osprey-dcs/trigger-output-fmc/trigger-output-fmc.kicad_pcb

## KiCad design trigger-output-fmc.kicad_pcb (2026-10-09)

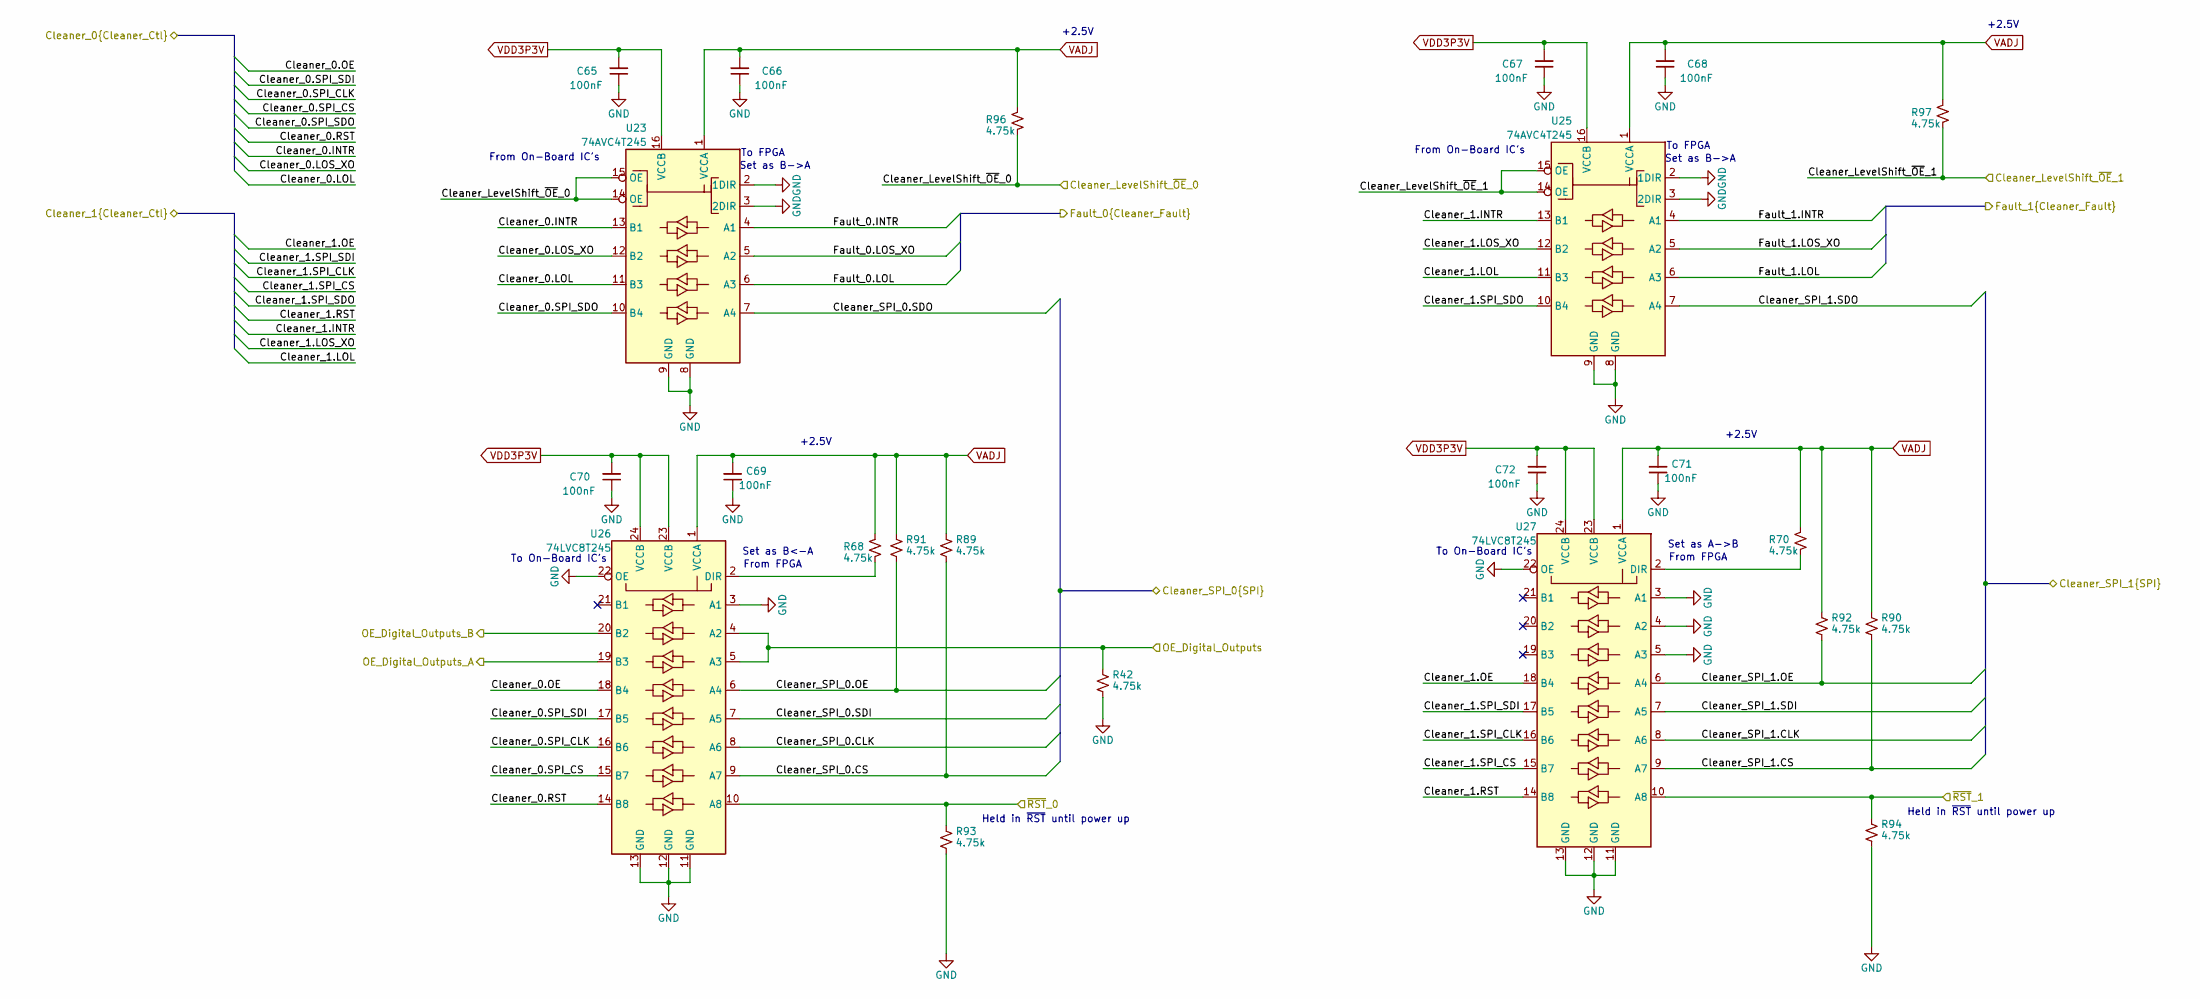
[picture p1: schematic Level_Shift.kicad_sch, Trigger Output FMC]

Parts:
C65, C66, C67, C68, C69, C70, C71, C72: 100nF; C_0402_1005Metric; MPN GCM155R71H104KE02J
R42, R68, R70, R89, R90, R91, R92, R93, R94, R96, R97: 4.75k; R_0402_1005Metric; MPN RC0402FR-074K75L
U23, U25: 74AVC4T245; TSSOP-16_4.4x5mm_P0.65mm; MPN SN74AVC4T245PWR
U26, U27: 74LVC8T245; TSSOP-24_4.4x7.8mm_P0.65mm; MPN SN74LVC8T245PWR

Connections:
/Digital IO/OE_A: U26.19 (B3); also elsewhere on the board
/Digital IO/OE_B: U26.20 (B2); also elsewhere on the board
/FMC/Cleaner_Fault_0.INTR: U23.4 (A1); also elsewhere on the board
/FMC/Cleaner_Fault_0.LOL: U23.6 (A3); also elsewhere on the board
/FMC/Cleaner_Fault_0.LOS_XO: U23.5 (A2); also elsewhere on the board
/FMC/Cleaner_Fault_1.INTR: U25.4 (A1); also elsewhere on the board
/FMC/Cleaner_Fault_1.LOL: U25.6 (A3); also elsewhere on the board
/FMC/Cleaner_Fault_1.LOS_XO: U25.5 (A2); also elsewhere on the board
/FMC/Cleaner_LevelShift_~OE_0: R96.1, U23.14 (OE), U23.15 (OE); also elsewhere on the board
/FMC/Cleaner_LevelShift_~OE_1: R97.1, U25.14 (OE), U25.15 (OE); also elsewhere on the board
/FMC/Cleaner_SPI_0.CLK: U26.8 (A6); also elsewhere on the board
/FMC/Cleaner_SPI_0.CS: R89.1, U26.9 (A7); also elsewhere on the board
/FMC/Cleaner_SPI_0.OE: R91.1, U26.6 (A4); also elsewhere on the board
/FMC/Cleaner_SPI_0.SDI: U26.7 (A5); also elsewhere on the board
/FMC/Cleaner_SPI_0.SDO: U23.7 (A4); also elsewhere on the board
/FMC/Cleaner_SPI_1.CLK: U27.8 (A6); also elsewhere on the board
/FMC/Cleaner_SPI_1.CS: R90.1, U27.9 (A7); also elsewhere on the board
/FMC/Cleaner_SPI_1.OE: R92.1, U27.6 (A4); also elsewhere on the board
/FMC/Cleaner_SPI_1.SDI: U27.7 (A5); also elsewhere on the board
/FMC/Cleaner_SPI_1.SDO: U25.7 (A4); also elsewhere on the board
/FMC/Cleaner_~RST_0: R93.2, U26.10 (A8); also elsewhere on the board
/FMC/Cleaner_~RST_1: R94.2, U27.10 (A8); also elsewhere on the board
/FMC/OE_Digital_Outputs: R42.2, U26.4 (A2), U26.5 (A3); also elsewhere on the board
/Jitter Cleaner0/Control.INTR: U23.13 (B1); also elsewhere on the board
/Jitter Cleaner0/Control.LOL: U23.11 (B3); also elsewhere on the board
/Jitter Cleaner0/Control.LOS_XO: U23.12 (B2); also elsewhere on the board
/Jitter Cleaner0/Control.OE: U26.18 (B4); also elsewhere on the board
/Jitter Cleaner0/Control.RST: U26.14 (B8); also elsewhere on the board
/Jitter Cleaner0/Control.SPI_CLK: U26.16 (B6); also elsewhere on the board
/Jitter Cleaner0/Control.SPI_CS: U26.15 (B7); also elsewhere on the board
/Jitter Cleaner0/Control.SPI_SDI: U26.17 (B5); also elsewhere on the board
/Jitter Cleaner0/Control.SPI_SDO: U23.10 (B4); also elsewhere on the board
/Jitter Cleaner1/Control.INTR: U25.13 (B1); also elsewhere on the board
/Jitter Cleaner1/Control.LOL: U25.11 (B3); also elsewhere on the board
/Jitter Cleaner1/Control.LOS_XO: U25.12 (B2); also elsewhere on the board
/Jitter Cleaner1/Control.OE: U27.18 (B4); also elsewhere on the board
/Jitter Cleaner1/Control.RST: U27.14 (B8); also elsewhere on the board
/Jitter Cleaner1/Control.SPI_CLK: U27.16 (B6); also elsewhere on the board
/Jitter Cleaner1/Control.SPI_CS: U27.15 (B7); also elsewhere on the board
/Jitter Cleaner1/Control.SPI_SDI: U27.17 (B5); also elsewhere on the board
/Jitter Cleaner1/Control.SPI_SDO: U25.10 (B4); also elsewhere on the board
GND: C65.1, C66.1, C67.1, C68.1, C69.1, C70.1, C71.1, C72.1, R42.1, R93.1, R94.1, U23.2 (1DIR), U23.3 (2DIR), U23.8 (GND), U23.9 (GND), U25.2 (1DIR), U25.3 (2DIR), U25.8 (GND), U25.9 (GND), U26.3 (A1), U26.11 (GND), U26.12 (GND), U26.13 (GND), U26.22 (OE), U27.3 (A1), U27.4 (A2), U27.5 (A3), U27.11 (GND), U27.12 (GND), U27.13 (GND), U27.22 (OE); also elsewhere on the board
unnamed: R68.1, U26.2 (DIR)
unnamed: R70.1, U27.2 (DIR)
VADJ: C66.2, C68.2, C69.2, C71.2, R68.2, R70.2, R89.2, R90.2, R91.2, R92.2, R96.2, R97.2, U23.1 (VCCA), U25.1 (VCCA), U26.1 (VCCA), U27.1 (VCCA); also elsewhere on the board
VDD3P3V: C65.2, C67.2, C70.2, C72.2, U23.16 (VCCB), U25.16 (VCCB), U26.23 (VCCB), U26.24 (VCCB), U27.23 (VCCB), U27.24 (VCCB); also elsewhere on the board

Notes on the sheet:
Held in ~{RST} until power up
To FPGA
To On-Board IC's
+2.5V
From On-Board IC's
Set as B<-A
From FPGA
Set as B->A
Set as A->B

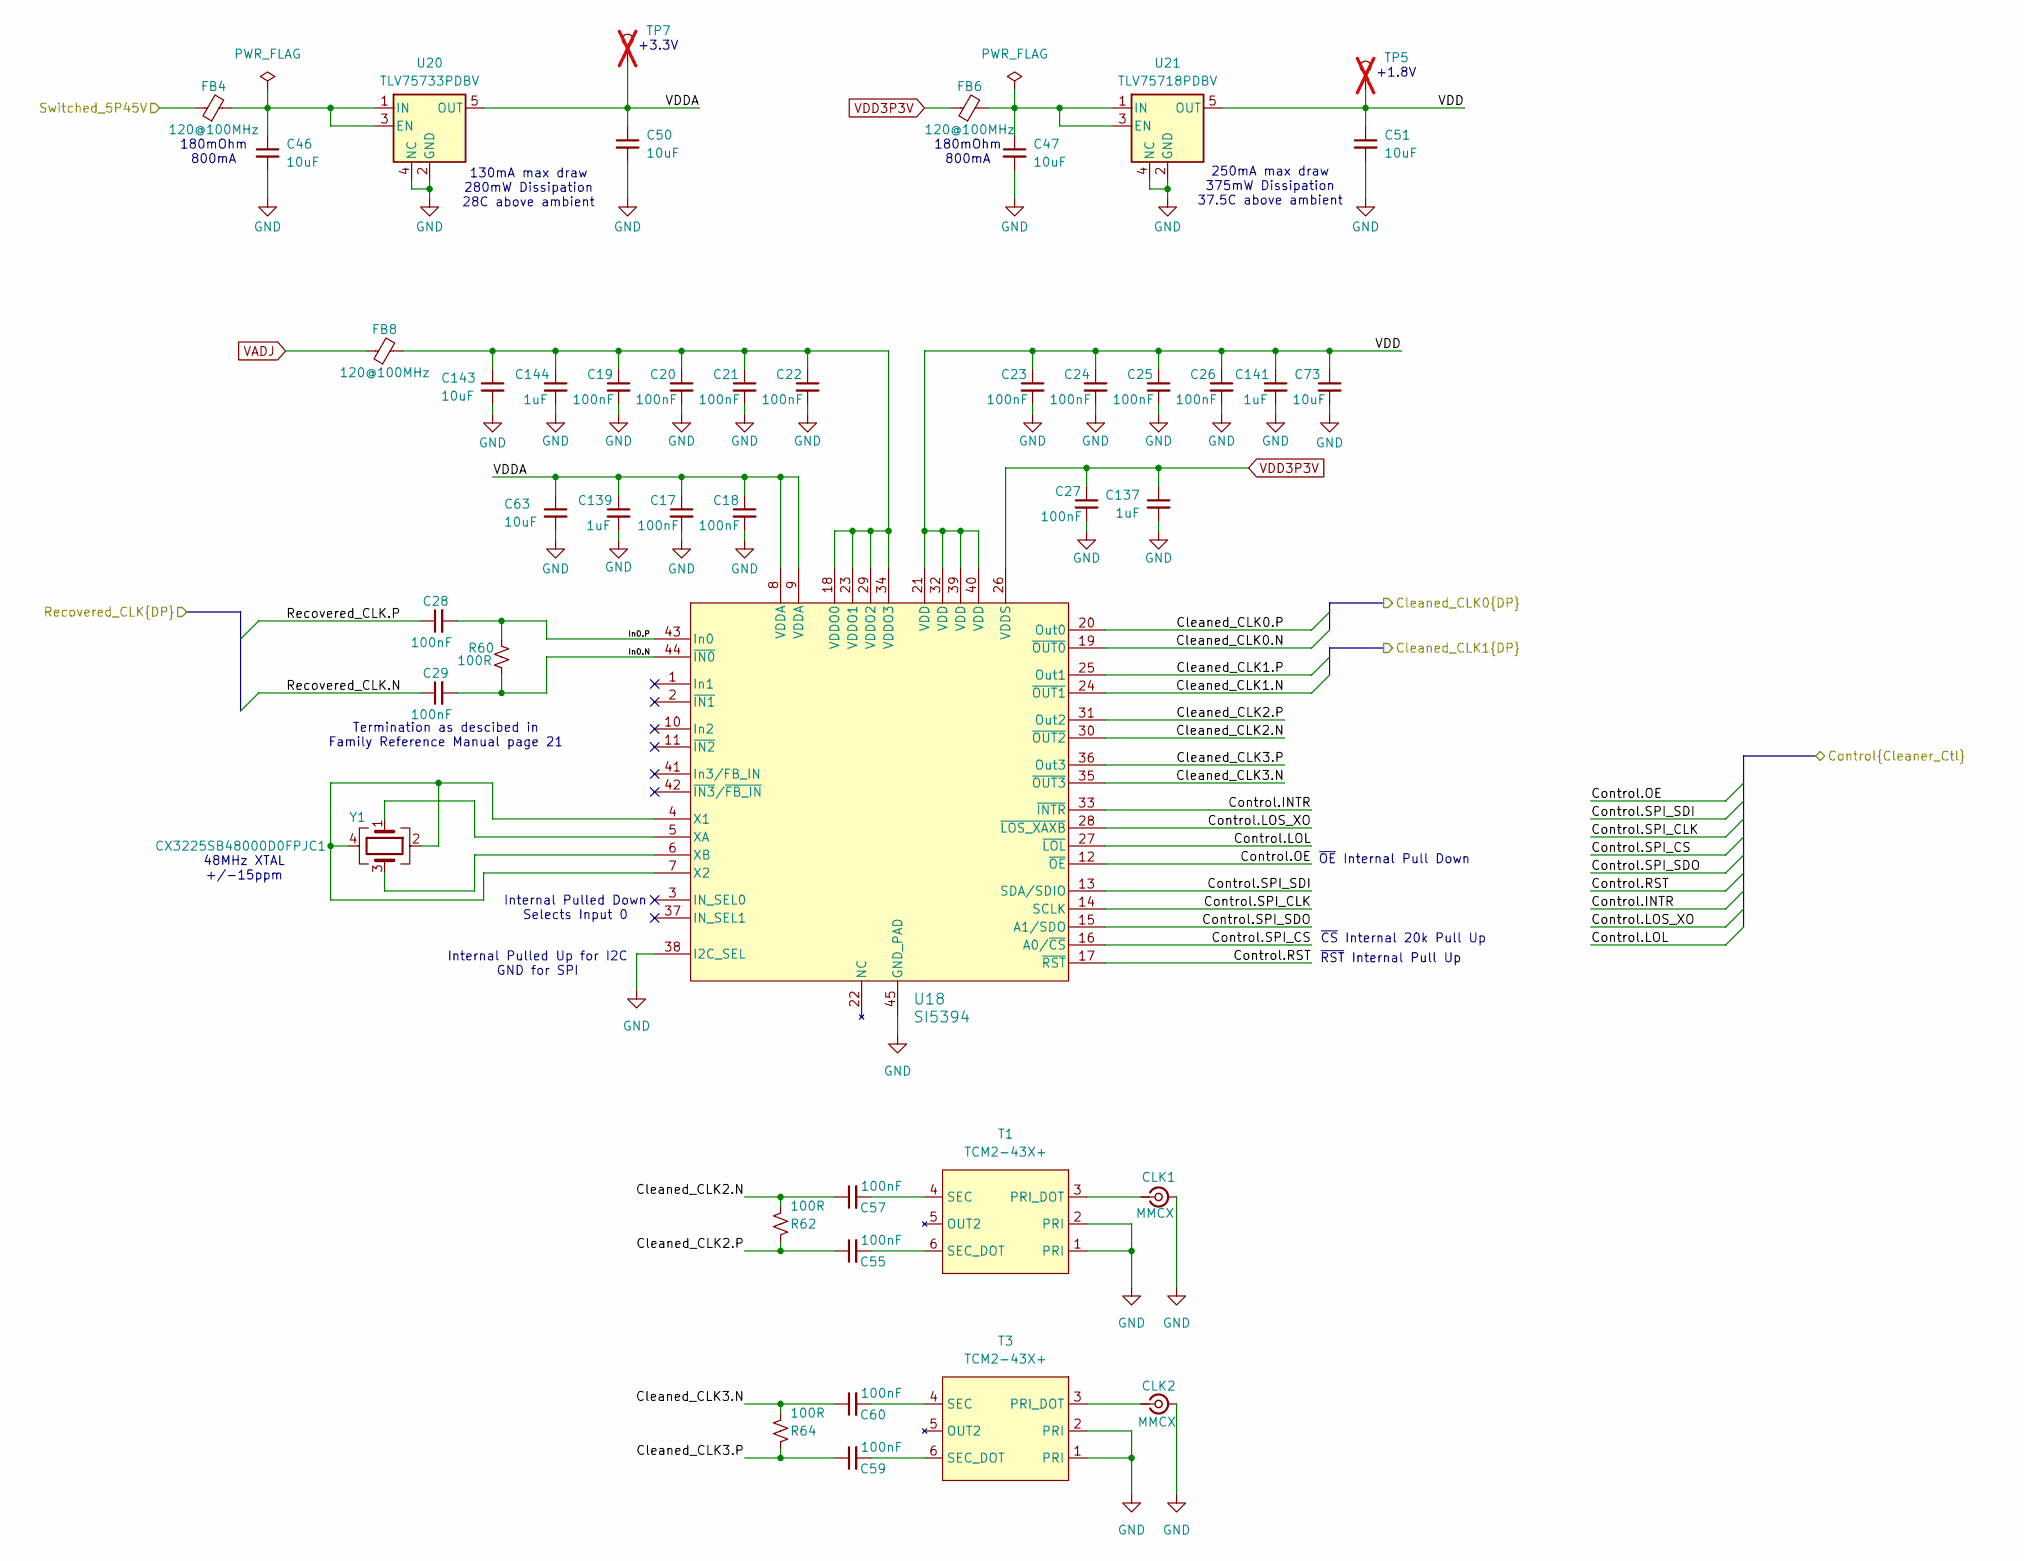
[picture p2: schematic Jitter_Cleaner.kicad_sch, Trigger Output FMC]

Parts:
C17, C18, C19, C20, C21, C22, C23, C24, C25, C26, C27, C28, C29, C55, C57, C59, C60: 100nF; C_0402_1005Metric; MPN GCM155R71H104KE02J
C46, C47, C50, C51, C63, C73, C143: 10uF; C_0805_2012Metric; MPN GRM21BR61E106KA73L
C137, C139, C141, C144: 1uF; C_0603_1608Metric; MPN GCM188R71E105KA64D
CLK1, CLK2: MMCX; MMCX_Molex_73415-1471_Vertical; MPN MMCX-J-P-H-ST-TH1
FB4, FB6, FB8: 120@100MHz; L_0603_1608Metric; MPN BLM18AG121SN1D
R60: 100R; R_0402_1005Metric; MPN RC0402FR-07100RL
R62, R64: 100R; R_0603_1608Metric; MPN RG1608P-101-B-T5
T1, T3: TCM2-43X+; Mini-Circuits_DB1627_rounded_pads; MPN TCM2-43X+
TP5, TP7: Keystone5000; TestPoint_Keystone_5000-5004_Miniature; MPN 5000; not fitted
U18: SI5394; QFN-44-1EP_7x7mm_P0.5mm_EP5.2x5.2mm_ThermalVias; MPN SI5394A-A-GM
U20: TLV75733PDBV; SOT-23-5; MPN TLV75733PDBV
U21: TLV75718PDBV; SOT-23-5; MPN TLV75718PDBV
Y1: CX3225SB48000D0FPJC1; Crystal_SMD_Abracon_ABM8AIG-4Pin_3.2x2.5mm; MPN CX3225SB48000D0FPJC1

Connections:
/Digital IO/Switched_5P45V: FB4.1; also elsewhere on the board
/FMC/Cleaned_CLK_0.N: U18.19 (~OUT0); also elsewhere on the board
/FMC/Cleaned_CLK_0.P: U18.20 (Out0); also elsewhere on the board
/FMC/FMC_GBTCLK0.N: U18.24 (~OUT1); also elsewhere on the board
/FMC/FMC_GBTCLK0.P: U18.25 (Out1); also elsewhere on the board
/FMC/Recovered_CLK_0.N: C29.1; also elsewhere on the board
/FMC/Recovered_CLK_0.P: C28.1; also elsewhere on the board
/Jitter Cleaner0/Cleaned_CLK2.N: C57.1, R62.2, U18.30 (~OUT2)
/Jitter Cleaner0/Cleaned_CLK2.P: C55.1, R62.1, U18.31 (Out2)
/Jitter Cleaner0/Cleaned_CLK3.N: C60.1, R64.2, U18.35 (~OUT3)
/Jitter Cleaner0/Cleaned_CLK3.P: C59.1, R64.1, U18.36 (Out3)
/Jitter Cleaner0/Control.INTR: U18.33 (~INTR); also elsewhere on the board
/Jitter Cleaner0/Control.LOL: U18.27 (~LOL); also elsewhere on the board
/Jitter Cleaner0/Control.LOS_XO: U18.28 (~LOS_XAXB); also elsewhere on the board
/Jitter Cleaner0/Control.OE: U18.12 (~OE); also elsewhere on the board
/Jitter Cleaner0/Control.RST: U18.17 (~RST); also elsewhere on the board
/Jitter Cleaner0/Control.SPI_CLK: U18.14 (SCLK); also elsewhere on the board
/Jitter Cleaner0/Control.SPI_CS: U18.16 (A0/~CS); also elsewhere on the board
/Jitter Cleaner0/Control.SPI_SDI: U18.13 (SDA/SDIO); also elsewhere on the board
/Jitter Cleaner0/Control.SPI_SDO: U18.15 (A1/SDO); also elsewhere on the board
/Jitter Cleaner0/In0.N: C29.2, R60.2, U18.44 (~IN0)
/Jitter Cleaner0/In0.P: C28.2, R60.1, U18.43 (In0)
/Jitter Cleaner0/VDD: C23.1, C24.1, C25.1, C26.1, C51.1, C73.1, C141.1, TP5.1, U18.21 (VDD), U18.32 (VDD), U18.39 (VDD), U18.40 (VDD), U21.5 (OUT)
/Jitter Cleaner0/VDDA: C17.1, C18.1, C50.1, C63.1, C139.1, TP7.1, U18.8 (VDDA), U18.9 (VDDA), U20.5 (OUT)
GND: C17.2, C18.2, C19.2, C20.2, C21.2, C22.2, C23.2, C24.2, C25.2, C26.2, C27.2, C46.2, C47.2, C50.2, C51.2, C63.2, C73.2, C137.2, C139.2, C141.2, C143.2, C144.2, CLK1.2 (Ext), CLK2.2 (Ext), T1.1 (PRI), T1.2 (PRI), T3.1 (PRI), T3.2 (PRI), U18.38 (I2C_SEL), U18.45 (GND_PAD), U20.2 (GND), U20.4 (NC), U21.2 (GND), U21.4 (NC); also elsewhere on the board
unnamed: CLK1.1 (In), T1.3 (PRI_DOT)
unnamed: CLK2.1 (In), T3.3 (PRI_DOT)
unnamed: C57.2, T1.4 (SEC)
unnamed: C55.2, T1.6 (SEC_DOT)
unnamed: C60.2, T3.4 (SEC)
unnamed: C59.2, T3.6 (SEC_DOT)
unnamed: C19.1, C20.1, C21.1, C22.1, C143.1, C144.1, FB8.2, U18.18 (VDDO0), U18.23 (VDDO1), U18.29 (VDDO2), U18.34 (VDDO3)
unnamed: U18.4 (X1), U18.7 (X2), Y1.2, Y1.4
unnamed: U18.5 (XA), Y1.1
unnamed: U18.6 (XB), Y1.3
unnamed: C46.1, FB4.2, U20.1 (IN), U20.3 (EN)
unnamed: C47.1, FB6.2, U21.1 (IN), U21.3 (EN)
VADJ: FB8.1; also elsewhere on the board
VDD3P3V: C27.1, C137.1, FB6.1, U18.26 (VDDS); also elsewhere on the board

Parts of its further copies:
C30, C31, C32, C36, C37, C38, C39, C40, C41, C42, C43, C44, C45, C56, C58, C61, C62: 100nF; C_0402_1005Metric; MPN GCM155R71H104KE02J
C64, C74, C75, C76, C77, C78, C145: 10uF; C_0805_2012Metric; MPN GRM21BR61E106KA73L
C138, C140, C142, C146: 1uF; C_0603_1608Metric; MPN GCM188R71E105KA64D
CLK3, CLK4: MMCX; MMCX_Molex_73415-1471_Vertical; MPN MMCX-J-P-H-ST-TH1
FB5, FB7, FB9: 120@100MHz; L_0603_1608Metric; MPN BLM18AG121SN1D
R61: 100R; R_0402_1005Metric; MPN RC0402FR-07100RL
R63, R65: 100R; R_0603_1608Metric; MPN RG1608P-101-B-T5
T2, T4: TCM2-43X+; Mini-Circuits_DB1627_rounded_pads; MPN TCM2-43X+
TP6, TP9: Keystone5000; TestPoint_Keystone_5000-5004_Miniature; MPN 5000; not fitted
U19: SI5394; QFN-44-1EP_7x7mm_P0.5mm_EP5.2x5.2mm_ThermalVias; MPN SI5394A-A-GM
U24: TLV75733PDBV; SOT-23-5; MPN TLV75733PDBV
U28: TLV75718PDBV; SOT-23-5; MPN TLV75718PDBV
Y2: CX3225SB48000D0FPJC1; Crystal_SMD_Abracon_ABM8AIG-4Pin_3.2x2.5mm; MPN CX3225SB48000D0FPJC1

Connections of its further copies:
/Digital IO/Switched_5P45V: FB5.1; also elsewhere on the board
/FMC/Cleaned_CLK_1.N: U19.24 (~OUT1); also elsewhere on the board
/FMC/Cleaned_CLK_1.P: U19.25 (Out1); also elsewhere on the board
/FMC/FMC_GBTCLK1.N: U19.19 (~OUT0); also elsewhere on the board
/FMC/FMC_GBTCLK1.P: U19.20 (Out0); also elsewhere on the board
/FMC/Recovered_CLK_1.N: C31.1; also elsewhere on the board
/FMC/Recovered_CLK_1.P: C30.1; also elsewhere on the board
/Jitter Cleaner1/Cleaned_CLK2.N: C58.1, R63.2, U19.30 (~OUT2)
/Jitter Cleaner1/Cleaned_CLK2.P: C56.1, R63.1, U19.31 (Out2)
/Jitter Cleaner1/Cleaned_CLK3.N: C62.1, R65.2, U19.35 (~OUT3)
/Jitter Cleaner1/Cleaned_CLK3.P: C61.1, R65.1, U19.36 (Out3)
/Jitter Cleaner1/Control.INTR: U19.33 (~INTR); also elsewhere on the board
/Jitter Cleaner1/Control.LOL: U19.27 (~LOL); also elsewhere on the board
/Jitter Cleaner1/Control.LOS_XO: U19.28 (~LOS_XAXB); also elsewhere on the board
/Jitter Cleaner1/Control.OE: U19.12 (~OE); also elsewhere on the board
/Jitter Cleaner1/Control.RST: U19.17 (~RST); also elsewhere on the board
/Jitter Cleaner1/Control.SPI_CLK: U19.14 (SCLK); also elsewhere on the board
/Jitter Cleaner1/Control.SPI_CS: U19.16 (A0/~CS); also elsewhere on the board
/Jitter Cleaner1/Control.SPI_SDI: U19.13 (SDA/SDIO); also elsewhere on the board
/Jitter Cleaner1/Control.SPI_SDO: U19.15 (A1/SDO); also elsewhere on the board
/Jitter Cleaner1/In0.N: C31.2, R61.2, U19.44 (~IN0)
/Jitter Cleaner1/In0.P: C30.2, R61.1, U19.43 (In0)
/Jitter Cleaner1/VDD: C41.1, C43.1, C44.1, C45.1, C74.1, C78.1, C142.1, TP9.1, U19.21 (VDD), U19.32 (VDD), U19.39 (VDD), U19.40 (VDD), U28.5 (OUT)
/Jitter Cleaner1/VDDA: C37.1, C39.1, C64.1, C76.1, C140.1, TP6.1, U19.8 (VDDA), U19.9 (VDDA), U24.5 (OUT)
GND: C32.2, C36.2, C37.2, C38.2, C39.2, C40.2, C41.2, C42.2, C43.2, C44.2, C45.2, C64.2, C74.2, C75.2, C76.2, C77.2, C78.2, C138.2, C140.2, C142.2, C145.2, C146.2, CLK3.2 (Ext), CLK4.2 (Ext), T2.1 (PRI), T2.2 (PRI), T4.1 (PRI), T4.2 (PRI), U19.38 (I2C_SEL), U19.45 (GND_PAD), U24.2 (GND), U24.4 (NC), U28.2 (GND), U28.4 (NC); also elsewhere on the board
unnamed: CLK3.1 (In), T2.3 (PRI_DOT)
unnamed: CLK4.1 (In), T4.3 (PRI_DOT)
unnamed: C58.2, T2.4 (SEC)
unnamed: C56.2, T2.6 (SEC_DOT)
unnamed: C62.2, T4.4 (SEC)
unnamed: C61.2, T4.6 (SEC_DOT)
unnamed: C32.1, C36.1, C38.1, C40.1, C145.1, C146.1, FB9.2, U19.18 (VDDO0), U19.23 (VDDO1), U19.29 (VDDO2), U19.34 (VDDO3)
unnamed: U19.4 (X1), U19.7 (X2), Y2.2, Y2.4
unnamed: U19.5 (XA), Y2.1
unnamed: U19.6 (XB), Y2.3
unnamed: C75.1, FB5.2, U24.1 (IN), U24.3 (EN)
unnamed: C77.1, FB7.2, U28.1 (IN), U28.3 (EN)
VADJ: FB9.1; also elsewhere on the board
VDD3P3V: C42.1, C138.1, FB7.1, U19.26 (VDDS); also elsewhere on the board

Notes on the sheet:
130mA max draw 280mW Dissipation 28C above ambient
~{CS} Internal 20k Pull Up
Internal Pulled Up for I2C GND for SPI
48MHz XTAL +/-15ppm
180mOhm 800mA
250mA max draw 375mW Dissipation 37.5C above ambient
~{RST} Internal Pull Up
Termination as descibed in Family Reference Manual page 21
+1.8V
+3.3V
Internal Pulled Down Selects Input 0
~{OE} Internal Pull Down

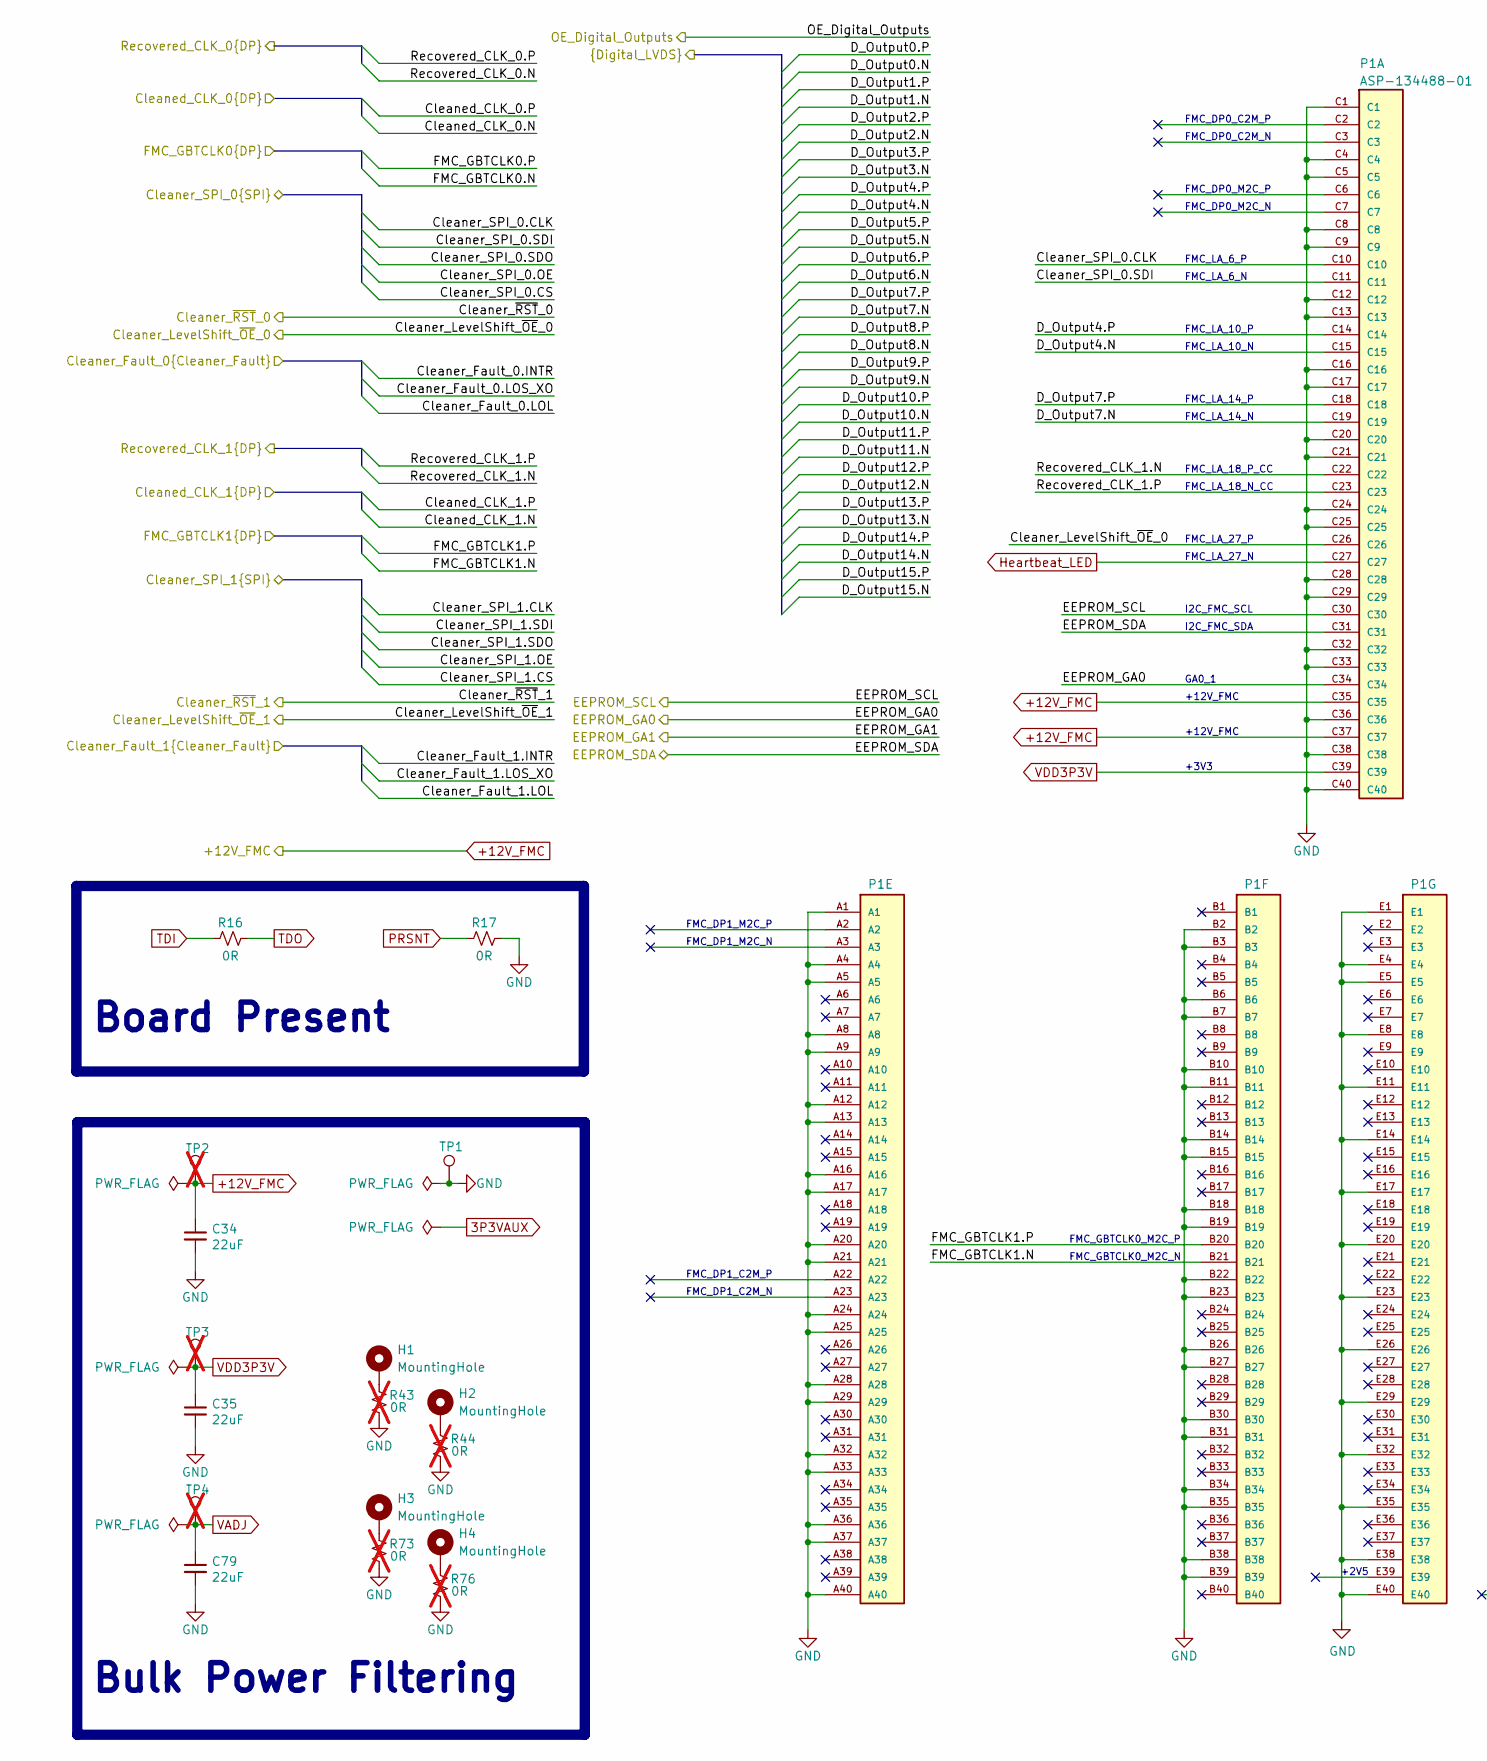
[picture p3: schematic fmc.kicad_sch, Trigger Output FMC, part in row 1, column 1]

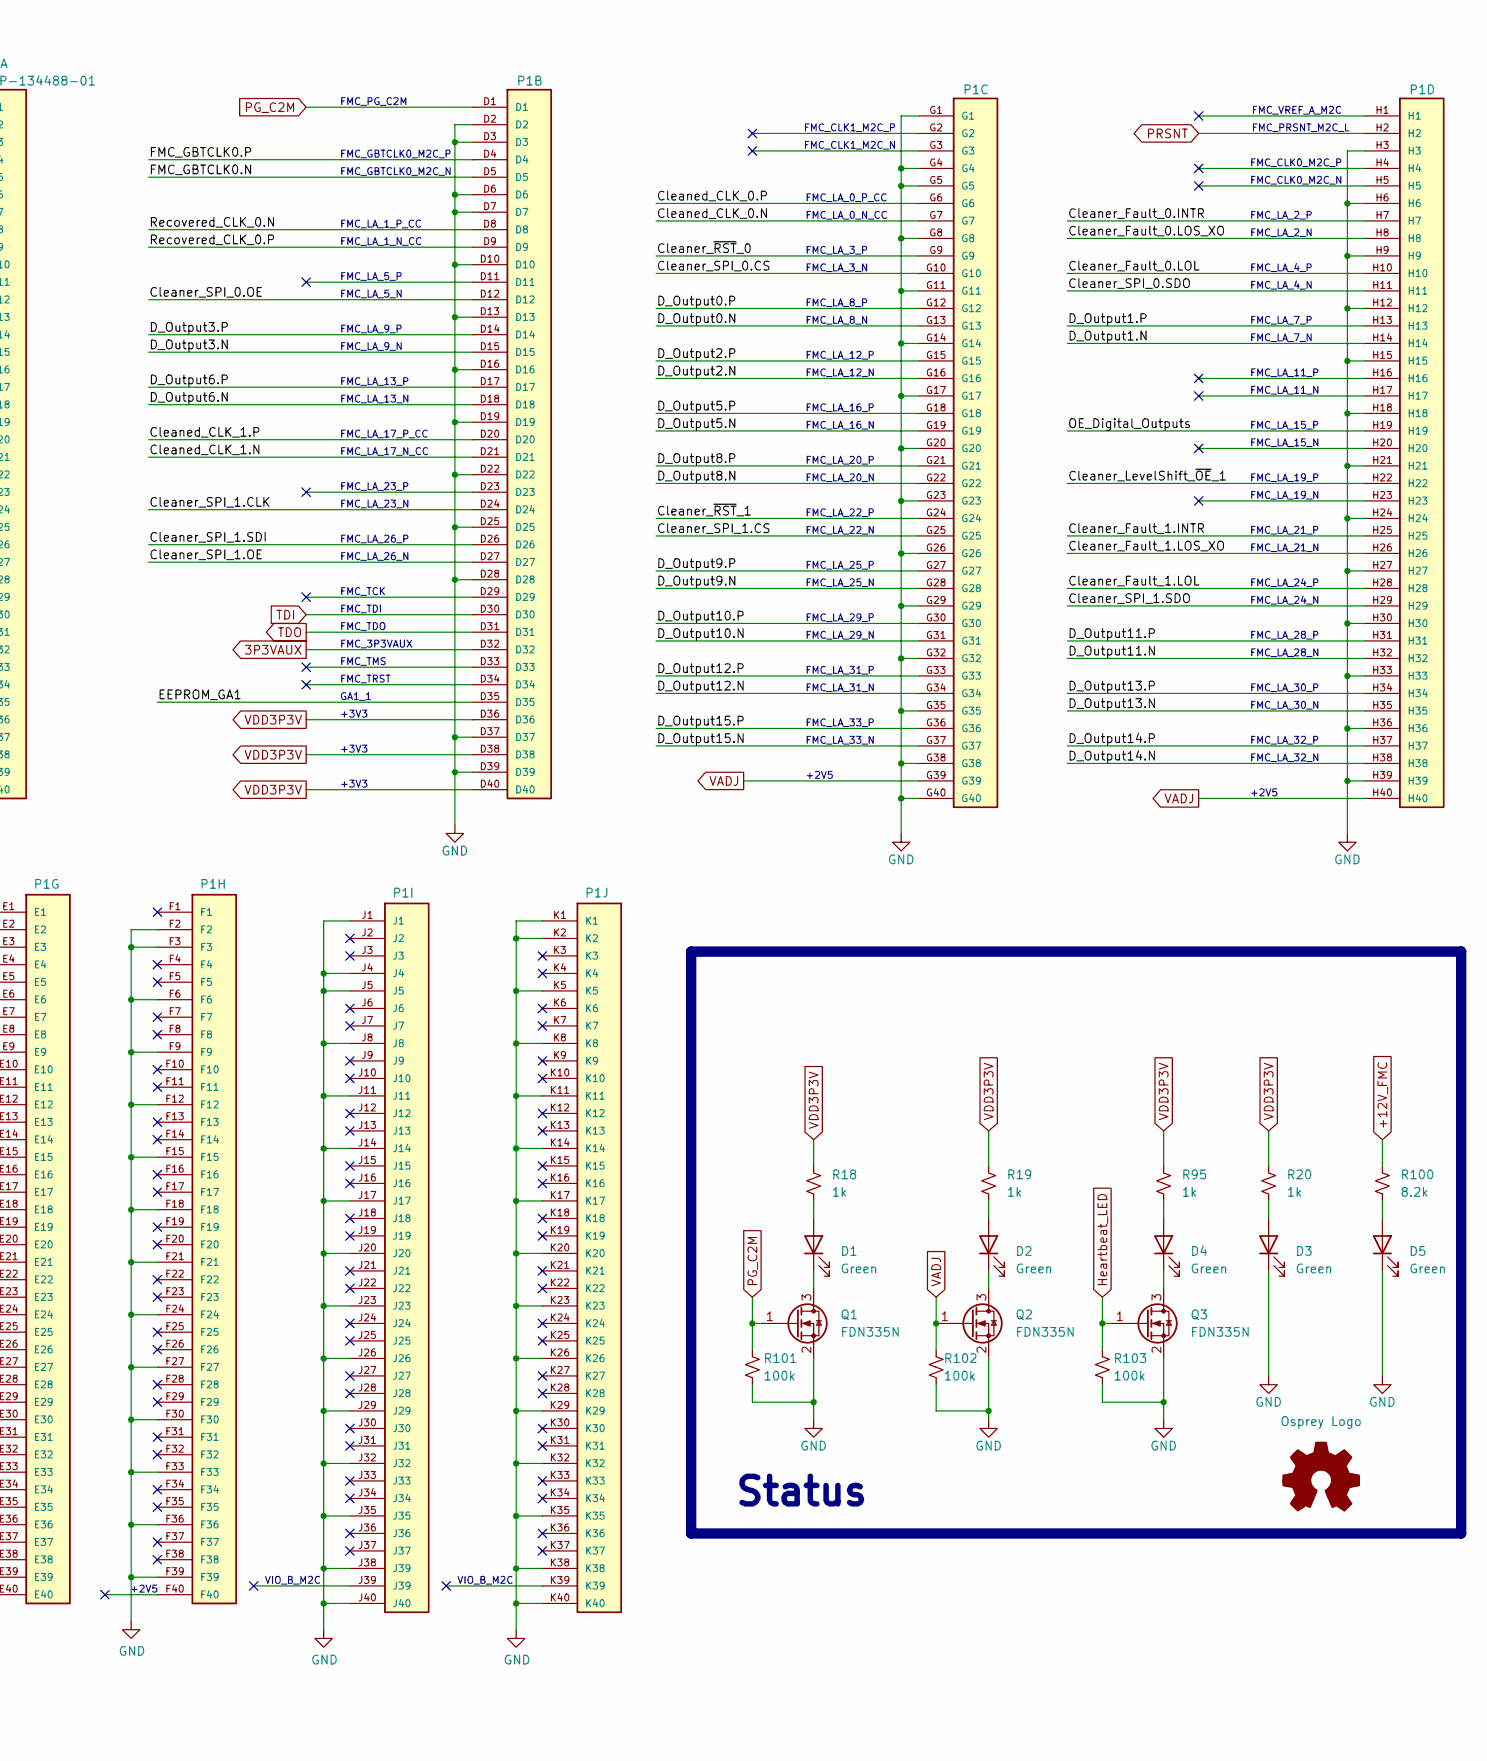
[picture p4: schematic fmc.kicad_sch, Trigger Output FMC, part in row 1, column 2]

Parts:
C34, C35, C79: 22uF; C_0805_2012Metric; MPN KGM21AR51E226MU
D1, D2, D3, D4, D5: Green; LED_0603_1608Metric; MPN APT1608CGCK
H1, H2: MountingHole; MountingHole_3.0mm_M2.5_Pad_3.3mm_UniversalMarbleSlot
H3, H4: MountingHole; MountingHole_3.0mm_3.8mm_Pad_3.3mm_UniversalMarbleSlot
Logo1: Osprey Logo; Logo_2X
P1: ASP-134488-01; Samtec_FMC_ASP-134602-01_10x40_P1.27mm_Vertical; MPN ASP-134488-01
Q1, Q2, Q3: FDN335N; SOT-23; MPN FDN335N
R16, R17: 0R; R_0603_1608Metric; MPN ERJ-3GEY0R00V
R18, R19, R20, R95: 1k; R_0603_1608Metric; MPN ESR03EZPF1001
R43, R44, R73, R76: 0R; R_0805_2012Metric; not fitted
R100: 8.2k; R_0603_1608Metric; MPN RC0603FR-078K2L
R101, R102, R103: 100k; R_0603_1608Metric; MPN RC0603FR-07100KL
TP1: Keystone5001; TestPoint_Keystone_5000-5004_Miniature; MPN 5001
TP2, TP3, TP4: Keystone5000; TestPoint_Keystone_5000-5004_Miniature; MPN 5000; not fitted

Connections:
3P3VAUX: P1.D32; also elsewhere on the board
+12V_FMC: C34.1, P1.C35, P1.C37, R100.2, TP2.1; also elsewhere on the board
/Digital IO/D_Output0.N: P1.G13; also elsewhere on the board
/Digital IO/D_Output0.P: P1.G12; also elsewhere on the board
/Digital IO/D_Output1.N: P1.H14; also elsewhere on the board
/Digital IO/D_Output1.P: P1.H13; also elsewhere on the board
/Digital IO/D_Output2.N: P1.G16; also elsewhere on the board
/Digital IO/D_Output2.P: P1.G15; also elsewhere on the board
/Digital IO/D_Output3.N: P1.D15; also elsewhere on the board
/Digital IO/D_Output3.P: P1.D14; also elsewhere on the board
/Digital IO/D_Output4.N: P1.C15; also elsewhere on the board
/Digital IO/D_Output4.P: P1.C14; also elsewhere on the board
/Digital IO/D_Output5.N: P1.G19; also elsewhere on the board
/Digital IO/D_Output5.P: P1.G18; also elsewhere on the board
/Digital IO/D_Output6.N: P1.D18; also elsewhere on the board
/Digital IO/D_Output6.P: P1.D17; also elsewhere on the board
/Digital IO/D_Output7.N: P1.C19; also elsewhere on the board
/Digital IO/D_Output7.P: P1.C18; also elsewhere on the board
/Digital IO/D_Output8.N: P1.G22; also elsewhere on the board
/Digital IO/D_Output8.P: P1.G21; also elsewhere on the board
/Digital IO/D_Output9.N: P1.G28; also elsewhere on the board
/Digital IO/D_Output9.P: P1.G27; also elsewhere on the board
/Digital IO/D_Output10.N: P1.G31; also elsewhere on the board
/Digital IO/D_Output10.P: P1.G30; also elsewhere on the board
/Digital IO/D_Output11.N: P1.H32; also elsewhere on the board
/Digital IO/D_Output11.P: P1.H31; also elsewhere on the board
/Digital IO/D_Output12.N: P1.G34; also elsewhere on the board
/Digital IO/D_Output12.P: P1.G33; also elsewhere on the board
/Digital IO/D_Output13.N: P1.H35; also elsewhere on the board
/Digital IO/D_Output13.P: P1.H34; also elsewhere on the board
/Digital IO/D_Output14.N: P1.H38; also elsewhere on the board
/Digital IO/D_Output14.P: P1.H37; also elsewhere on the board
/Digital IO/D_Output15.N: P1.G37; also elsewhere on the board
/Digital IO/D_Output15.P: P1.G36; also elsewhere on the board
/FMC/Cleaned_CLK_0.N: P1.G7; also elsewhere on the board
/FMC/Cleaned_CLK_0.P: P1.G6; also elsewhere on the board
/FMC/Cleaned_CLK_1.N: P1.D21; also elsewhere on the board
/FMC/Cleaned_CLK_1.P: P1.D20; also elsewhere on the board
/FMC/Cleaner_Fault_0.INTR: P1.H7; also elsewhere on the board
/FMC/Cleaner_Fault_0.LOL: P1.H10; also elsewhere on the board
/FMC/Cleaner_Fault_0.LOS_XO: P1.H8; also elsewhere on the board
/FMC/Cleaner_Fault_1.INTR: P1.H25; also elsewhere on the board
/FMC/Cleaner_Fault_1.LOL: P1.H28; also elsewhere on the board
/FMC/Cleaner_Fault_1.LOS_XO: P1.H26; also elsewhere on the board
/FMC/Cleaner_LevelShift_~OE_0: P1.C26; also elsewhere on the board
/FMC/Cleaner_LevelShift_~OE_1: P1.H22; also elsewhere on the board
/FMC/Cleaner_SPI_0.CLK: P1.C10; also elsewhere on the board
/FMC/Cleaner_SPI_0.CS: P1.G10; also elsewhere on the board
/FMC/Cleaner_SPI_0.OE: P1.D12; also elsewhere on the board
/FMC/Cleaner_SPI_0.SDI: P1.C11; also elsewhere on the board
/FMC/Cleaner_SPI_0.SDO: P1.H11; also elsewhere on the board
/FMC/Cleaner_SPI_1.CLK: P1.D24; also elsewhere on the board
/FMC/Cleaner_SPI_1.CS: P1.G25; also elsewhere on the board
/FMC/Cleaner_SPI_1.OE: P1.D27; also elsewhere on the board
/FMC/Cleaner_SPI_1.SDI: P1.D26; also elsewhere on the board
/FMC/Cleaner_SPI_1.SDO: P1.H29; also elsewhere on the board
/FMC/Cleaner_~RST_0: P1.G9; also elsewhere on the board
/FMC/Cleaner_~RST_1: P1.G24; also elsewhere on the board
/FMC/EEPROM_GA0: P1.C34; also elsewhere on the board
/FMC/EEPROM_GA1: P1.D35; also elsewhere on the board
/FMC/EEPROM_SCL: P1.C30; also elsewhere on the board
/FMC/EEPROM_SDA: P1.C31; also elsewhere on the board
/FMC/FMC_GBTCLK0.N: P1.D5; also elsewhere on the board
/FMC/FMC_GBTCLK0.P: P1.D4; also elsewhere on the board
/FMC/FMC_GBTCLK1.N: P1.B21; also elsewhere on the board
/FMC/FMC_GBTCLK1.P: P1.B20; also elsewhere on the board
/FMC/OE_Digital_Outputs: P1.H19; also elsewhere on the board
/FMC/Recovered_CLK_0.N: P1.D8; also elsewhere on the board
/FMC/Recovered_CLK_0.P: P1.D9; also elsewhere on the board
/FMC/Recovered_CLK_1.N: P1.C22; also elsewhere on the board
/FMC/Recovered_CLK_1.P: P1.C23; also elsewhere on the board
GND: C34.2, C35.2, C79.2, D3.1 (K), D5.1 (K), P1.A1, P1.A4, P1.A5, P1.A8, P1.A9, P1.A12, P1.A13, P1.A16, P1.A17, P1.A20, P1.A21, P1.A24, P1.A25, P1.A28, P1.A29, P1.A32, P1.A33, P1.A36, P1.A37, P1.A40, P1.B2, P1.B3, P1.B6, P1.B7, P1.B10, P1.B11, P1.B14, P1.B15, P1.B18, P1.B19, P1.B22, P1.B23, P1.B26, P1.B27, P1.B30, P1.B31, P1.B34, P1.B35, P1.B38, P1.B39, P1.C1, P1.C4, P1.C5, P1.C8, P1.C9, P1.C12, P1.C13, P1.C16, P1.C17, P1.C20, P1.C21, P1.C24, P1.C25, P1.C28, P1.C29, P1.C32, P1.C33, P1.C36, P1.C38, P1.C40, P1.D2, P1.D3, P1.D6, P1.D7, P1.D10, P1.D13, P1.D16, P1.D19, P1.D22, P1.D25, P1.D28, P1.D37, P1.D39, P1.E1, P1.E4, P1.E5, P1.E8, P1.E11, P1.E14, P1.E17, P1.E20, P1.E23, P1.E26, P1.E29, P1.E32, P1.E35, P1.E38, P1.E40, P1.F2, P1.F3, P1.F6, P1.F9, P1.F12, P1.F15, P1.F18, P1.F21, P1.F24, P1.F27, P1.F30, P1.F33, P1.F36, P1.F39, P1.G1, P1.G4, P1.G5, P1.G8, P1.G11, P1.G14, P1.G17, P1.G20, P1.G23, P1.G26, P1.G29, P1.G32, P1.G35, P1.G38, P1.G40, P1.H3, P1.H6, P1.H9, P1.H12, P1.H15, P1.H18, P1.H21, P1.H24, P1.H27, P1.H30, P1.H33, P1.H36, P1.H39, P1.J1, P1.J4, P1.J5, P1.J8, P1.J11, P1.J14, P1.J17, P1.J20, P1.J23, P1.J26, P1.J29, P1.J32, P1.J35, P1.J38 (J39), P1.J40, P1.K1, P1.K2, P1.K5, P1.K8, P1.K11, P1.K14, P1.K17, P1.K20, P1.K23, P1.K26, P1.K29, P1.K32, P1.K35, P1.K38, P1.K40, Q1.2 (S), Q2.2 (S), Q3.2 (S), R17.2, R43.1, R44.1, R73.1, R76.1, R101.1, R102.1, R103.1, TP1.1; also elsewhere on the board
Heartbeat_LED: P1.C27, Q3.1 (G), R103.2
unnamed: D1.2 (A), R18.1
unnamed: D1.1 (K), Q1.3 (D)
unnamed: D2.2 (A), R19.1
unnamed: D2.1 (K), Q2.3 (D)
unnamed: D3.2 (A), R20.1
unnamed: D4.2 (A), R95.1
unnamed: D4.1 (K), Q3.3 (D)
unnamed: D5.2 (A), R100.1
unnamed: H1.1, R43.2
unnamed: H2.1, R44.2
unnamed: H3.1, R73.2
unnamed: H4.1, R76.2
PG_C2M: P1.D1, Q1.1 (G), R101.2
PRSNT: P1.H2, R17.1
TDI: P1.D30, R16.2
TDO: P1.D31, R16.1
VADJ: C79.1, P1.G39, P1.H40, Q2.1 (G), R102.2, TP4.1; also elsewhere on the board
VDD3P3V: C35.1, P1.C39, P1.D36, P1.D38, P1.D40, R18.2, R19.2, R20.2, R95.2, TP3.1; also elsewhere on the board

Notes on the sheet:
FMC_LA_19_N
FMC_GBTCLK0_M2C_N
FMC_LA_3_P
FMC_LA_5_P
FMC_LA_32_P
FMC_CLK0_M2C_P
VIO_B_M2C
FMC_LA_4_P
FMC_LA_26_N
FMC_LA_20_P
FMC_LA_21_N
FMC_LA_29_N
FMC_LA_14_N
Board Present
FMC_LA_21_P
FMC_LA_22_P
FMC_LA_18_N_CC
FMC_3P3VAUX
FMC_LA_6_P
FMC_LA_19_P
FMC_LA_7_N
FMC_LA_30_P
Status
+2V5
FMC_VREF_A_M2C
FMC_CLK0_M2C_N
FMC_LA_9_N
FMC_LA_2_N
FMC_LA_16_P
FMC_LA_31_P
FMC_LA_10_N
+3V3
FMC_LA_14_P
FMC_LA_32_N
GA0_1
FMC_LA_1_P_CC
FMC_DP1_M2C_P
FMC_TDI
+3V3
FMC_LA_11_P
FMC_DP0_C2M_P
FMC_PRSNT_M2C_L
+12V_FMC
FMC_LA_15_N
FMC_TDO
Bulk Power Filtering
FMC_LA_28_N
FMC_LA_9_P
FMC_LA_23_N
FMC_CLK1_M2C_N
FMC_DP1_C2M_P
FMC_LA_12_P
FMC_LA_18_P_CC
I2C_FMC_SCL
FMC_DP0_C2M_N
FMC_LA_22_N
FMC_LA_15_P
FMC_LA_10_P
FMC_LA_6_N
FMC_DP1_M2C_N
FMC_LA_20_N
FMC_CLK1_M2C_P
FMC_LA_33_P
FMC_LA_0_P_CC
FMC_LA_4_N
FMC_LA_5_N
FMC_LA_11_N
FMC_TMS
FMC_LA_28_P
FMC_GBTCLK0_M2C_P
FMC_LA_7_P
GA1_1
FMC_LA_30_N
FMC_TCK
FMC_LA_29_P
FMC_LA_1_N_CC
FMC_LA_8_N
FMC_LA_24_P
FMC_DP0_M2C_P
FMC_LA_17_N_CC
I2C_FMC_SDA
FMC_DP0_M2C_N
FMC_LA_27_N
FMC_LA_25_N
FMC_LA_0_N_CC
FMC_LA_13_P
FMC_LA_13_N
FMC_PG_C2M
FMC_LA_25_P
FMC_LA_12_N
FMC_LA_33_N
FMC_LA_27_P
FMC_DP1_C2M_N
FMC_LA_17_P_CC
FMC_LA_26_P
FMC_LA_23_P
FMC_LA_2_P
FMC_TRST
FMC_LA_3_N
FMC_LA_8_P
FMC_LA_31_N
FMC_LA_24_N
FMC_LA_16_N
