osprey-dcs/trigger-output-fmc/trigger-output-fmc.kicad_pcb

## KiCad design trigger-output-fmc.kicad_pcb (continued)

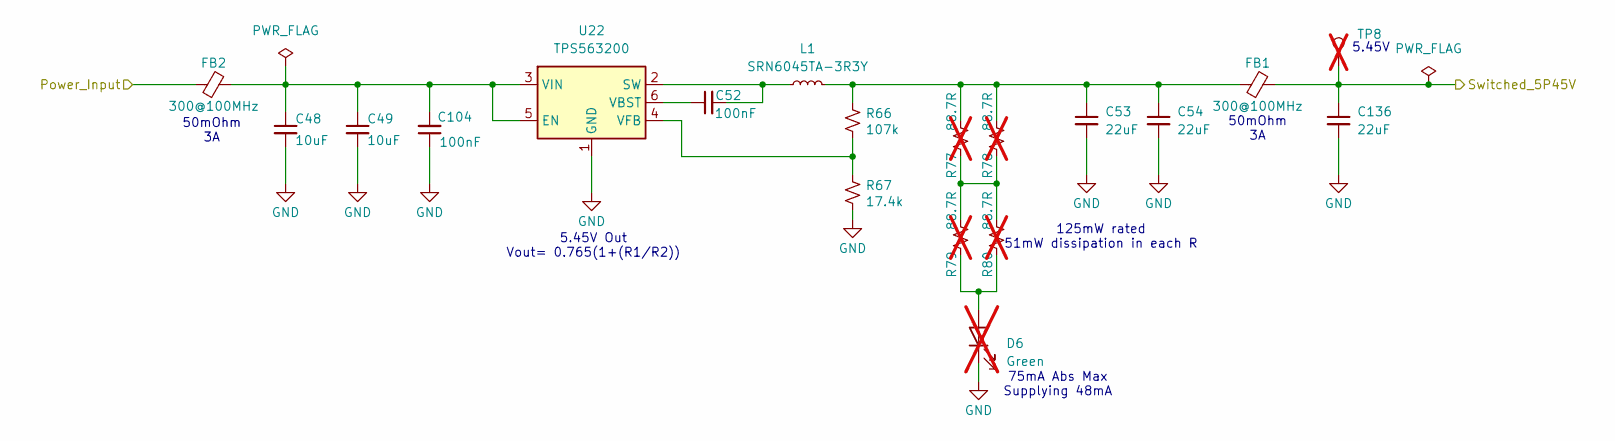
[picture p5: schematic Power.kicad_sch, Trigger Output FMC]

Parts:
C48, C49: 10uF; C_0805_2012Metric; MPN GRM21BR61E106KA73L
C52, C104: 100nF; C_0603_1608Metric; MPN GCM188R71H104KA57J
C53, C54, C136: 22uF; C_0805_2012Metric; MPN KGM21AR51E226MU
D6: Green; LED_0603_1608Metric; MPN APT1608CGCK; not fitted
FB1, FB2: 300@100MHz; L_0805_2012Metric; MPN 742792031
L1: SRN6045TA-3R3Y; L_Bourns_SRN6045TA; MPN SRN6045TA-3R3Y
R66: 107k; R_0603_1608Metric; MPN ERJ-3EKF1073V
R67: 17.4k; R_0603_1608Metric; MPN ERJ-3EKF1742V
R77, R78, R79, R80: 88.7R; R_0805_2012Metric; MPN CRCW080588R7FKEA; not fitted
TP8: Keystone5000; TestPoint_Keystone_5000-5004_Miniature; MPN 5000; not fitted
U22: TPS563200; SOT-23-6; MPN TPS563200DDCT

Connections:
+12V_FMC: FB2.1; also elsewhere on the board
/Digital IO/Switched_5P45V: C136.1, FB1.2, TP8.1; also elsewhere on the board
GND: C48.2, C49.2, C53.2, C54.2, C104.1, C136.2, D6.1 (K), R67.2, U22.1 (GND); also elsewhere on the board
unnamed: C53.1, C54.1, FB1.1, L1.2, R66.1, R77.2, R78.2
unnamed: D6.2 (A), R79.1, R80.1
unnamed: R77.1, R78.1, R79.2, R80.2
unnamed: C48.1, C49.1, C104.2, FB2.2, U22.3 (VIN), U22.5 (EN)
unnamed: C52.2, L1.1, U22.2 (SW)
unnamed: C52.1, U22.6 (VBST)
unnamed: R66.2, R67.1, U22.4 (VFB)

Notes on the sheet:
50mOhm 3A
5.45V
5.45V Out Vout= 0.765(1+(R1/R2))
75mA Abs Max Supplying 48mA
125mW rated 51mW dissipation in each R

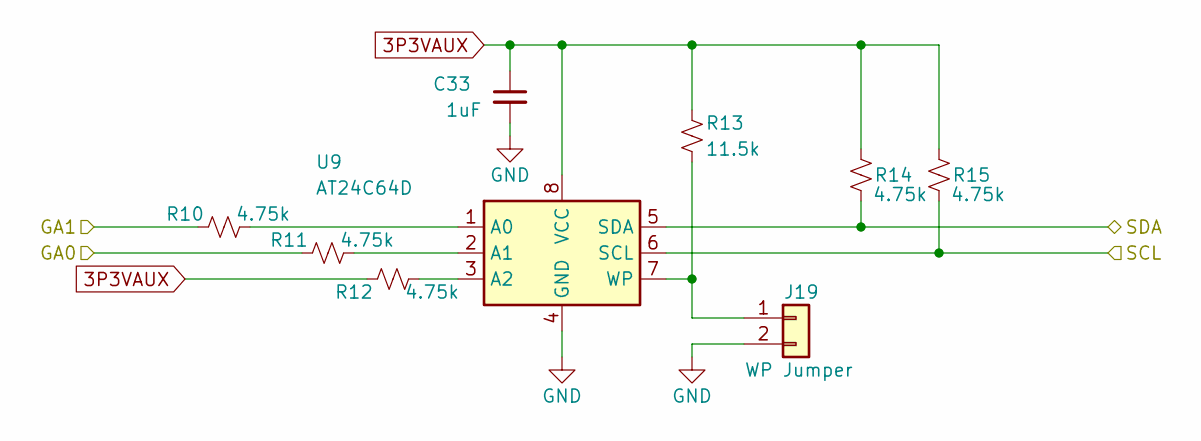
[picture p6: schematic eeprom.kicad_sch, Trigger Output FMC]

Parts:
C33: 1uF; C_0603_1608Metric; MPN GCM188R71E105KA64D
J19: WP Jumper; PinHeader_1x02_P2.54mm_Vertical; MPN M20-9990245
R10, R11, R12, R14, R15: 4.75k; R_0603_1608Metric; MPN RC0603FR-134K75L
R13: 11.5k; R_0603_1608Metric; MPN RC0603FR-0711K5L
U9: AT24C64D; SOIC-8_3.9x4.9mm_P1.27mm; MPN AT24C64D-SSHM-T

Connections:
3P3VAUX: C33.1, R12.1, R13.1, R14.1, R15.1, U9.8 (VCC); also elsewhere on the board
/FMC/EEPROM_GA0: R11.1; also elsewhere on the board
/FMC/EEPROM_GA1: R10.1; also elsewhere on the board
/FMC/EEPROM_SCL: R15.2, U9.6 (SCL); also elsewhere on the board
/FMC/EEPROM_SDA: R14.2, U9.5 (SDA); also elsewhere on the board
GND: C33.2, J19.2, U9.4 (GND); also elsewhere on the board
unnamed: J19.1, R13.2, U9.7 (WP)
unnamed: R10.2, U9.1 (A0)
unnamed: R11.2, U9.2 (A1)
unnamed: R12.2, U9.3 (A2)

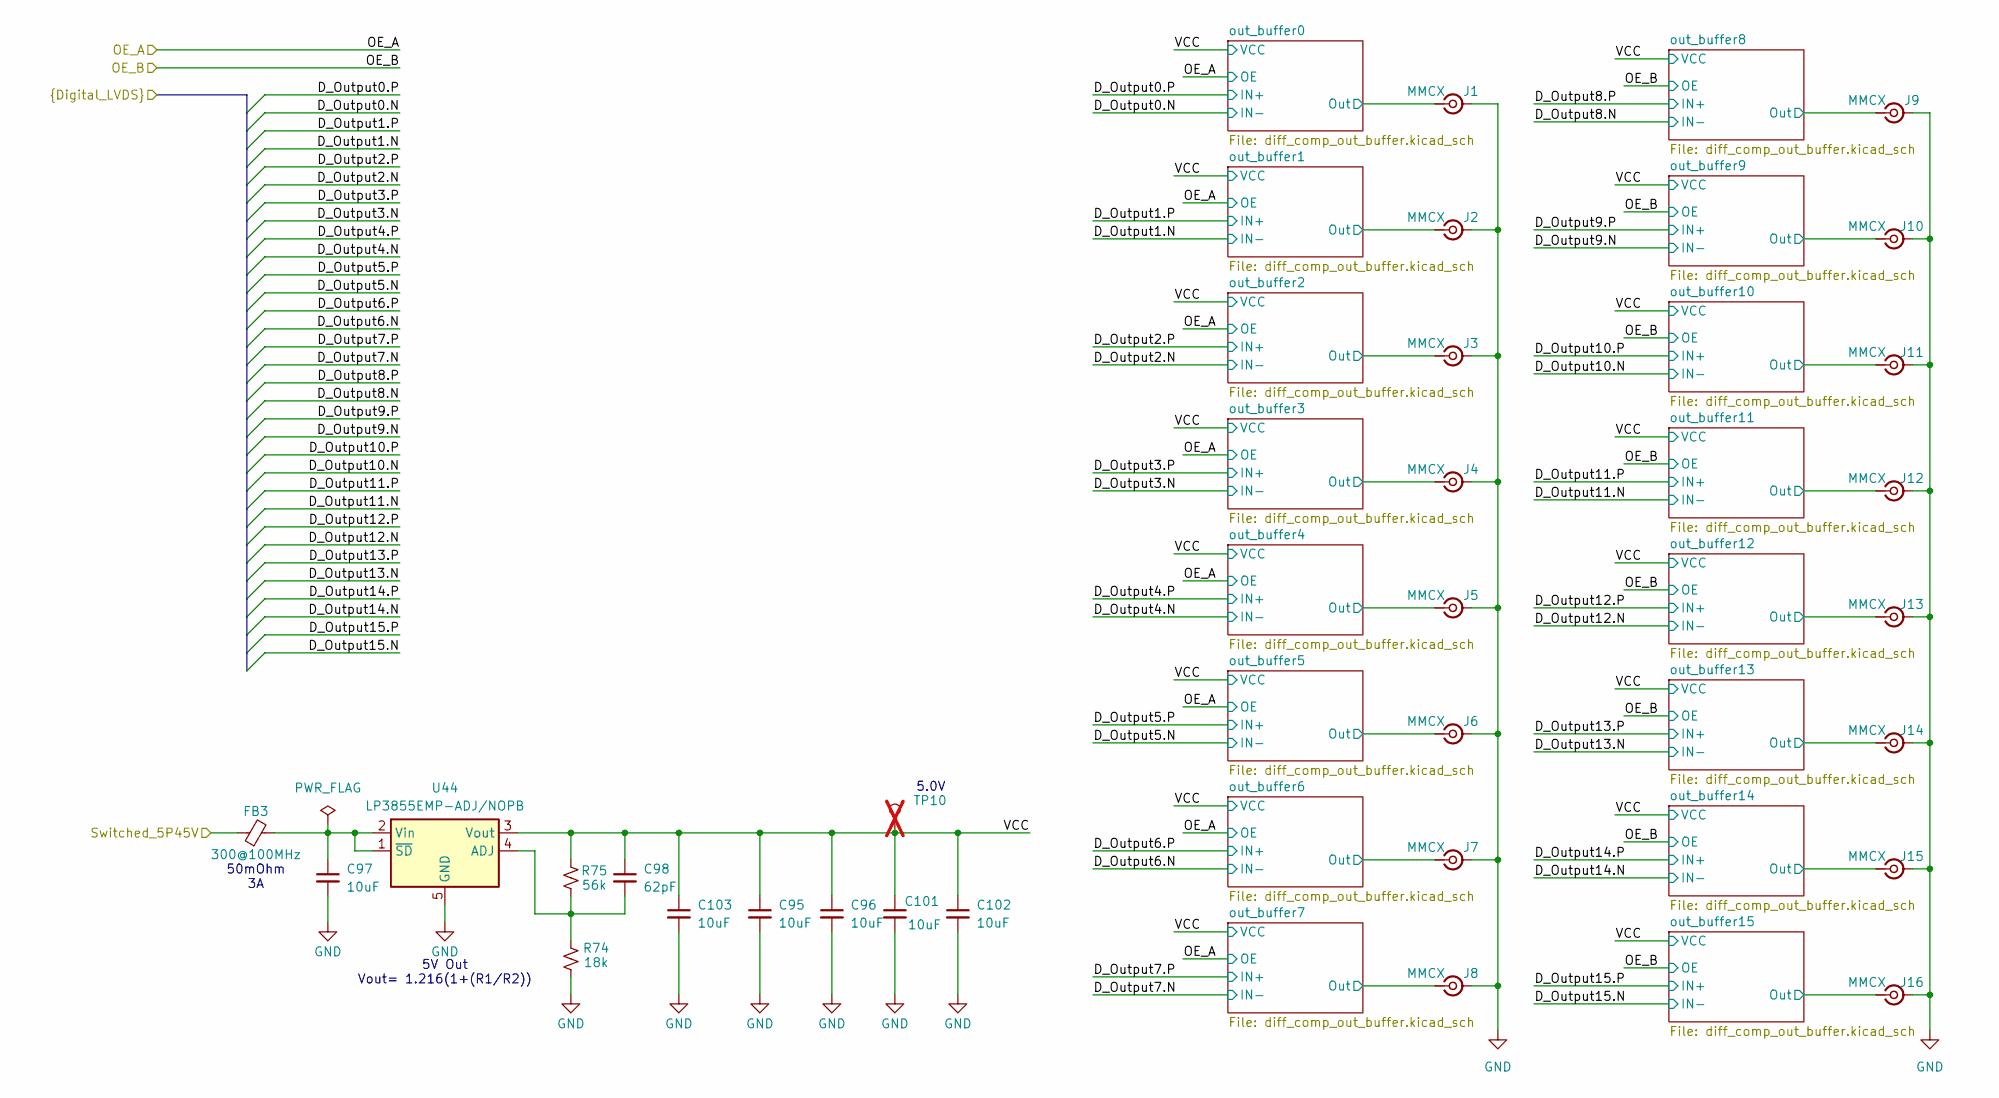
[picture p7: schematic Digital_IO.kicad_sch, Trigger Output FMC]

Parts:
C95, C96, C97, C101, C102, C103: 10uF; C_0805_2012Metric; MPN GRM21BR61E106KA73L
C98: 62pF; C_0603_1608Metric
FB3: 300@100MHz; L_0805_2012Metric; MPN 742792031
J1, J2, J3, J4, J5, J6, J7, J8, J9, J10, J11, J12, J13, J14, J15, J16: MMCX; MMCX_Molex_73415-1471_Vertical; MPN MMCX-J-P-H-ST-TH1
R74: 18k; R_0402_1005Metric; MPN AC0402FR-0718KL
R75: 56k; R_0402_1005Metric; MPN AF0402FR-0756KL
TP10: Keystone5000; TestPoint_Keystone_5000-5004_Miniature; MPN 5000; not fitted
U44: LP3855EMP-ADJ/NOPB; SOT-223-5; MPN LP3855EMP-ADJ/NOPB

Connections:
/Digital IO/Switched_5P45V: FB3.1; also elsewhere on the board
/Digital IO/VCC: C95.1, C96.1, C98.1, C101.1, C102.1, C103.1, R75.2, TP10.1, U44.3 (Vout); also elsewhere on the board
/Digital IO/out_buffer0/Out: J1.1 (In); also elsewhere on the board
/Digital IO/out_buffer1/Out: J2.1 (In); also elsewhere on the board
/Digital IO/out_buffer2/Out: J3.1 (In); also elsewhere on the board
/Digital IO/out_buffer3/Out: J4.1 (In); also elsewhere on the board
/Digital IO/out_buffer4/Out: J5.1 (In); also elsewhere on the board
/Digital IO/out_buffer5/Out: J6.1 (In); also elsewhere on the board
/Digital IO/out_buffer6/Out: J7.1 (In); also elsewhere on the board
/Digital IO/out_buffer7/Out: J8.1 (In); also elsewhere on the board
/Digital IO/out_buffer8/Out: J9.1 (In); also elsewhere on the board
/Digital IO/out_buffer9/Out: J10.1 (In); also elsewhere on the board
/Digital IO/out_buffer10/Out: J11.1 (In); also elsewhere on the board
/Digital IO/out_buffer11/Out: J12.1 (In); also elsewhere on the board
/Digital IO/out_buffer12/Out: J13.1 (In); also elsewhere on the board
/Digital IO/out_buffer13/Out: J14.1 (In); also elsewhere on the board
/Digital IO/out_buffer14/Out: J15.1 (In); also elsewhere on the board
/Digital IO/out_buffer15/Out: J16.1 (In); also elsewhere on the board
GND: C95.2, C96.2, C97.2, C101.2, C102.2, C103.2, J1.2 (Ext), J2.2 (Ext), J3.2 (Ext), J4.2 (Ext), J5.2 (Ext), J6.2 (Ext), J7.2 (Ext), J8.2 (Ext), J9.2 (Ext), J10.2 (Ext), J11.2 (Ext), J12.2 (Ext), J13.2 (Ext), J14.2 (Ext), J15.2 (Ext), J16.2 (Ext), R74.1, U44.5 (GND); also elsewhere on the board
unnamed: C98.2, R74.2, R75.1, U44.4 (ADJ)
unnamed: C97.1, FB3.2, U44.1 (~SD), U44.2 (Vin)

Notes on the sheet:
5V Out Vout= 1.216(1+(R1/R2))
50mOhm 3A
5.0V

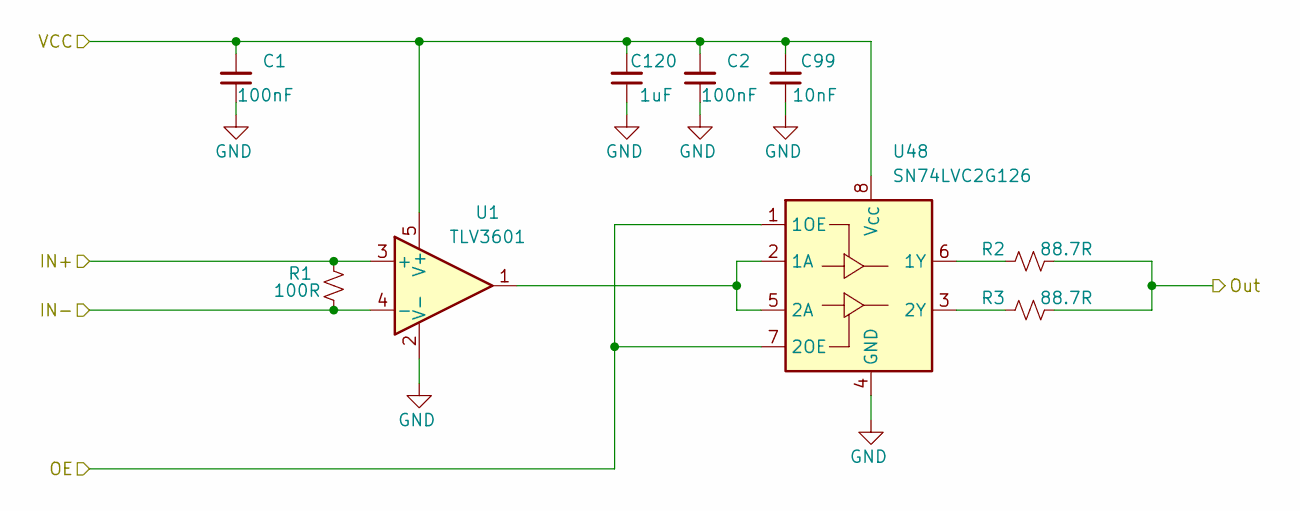
[picture p8: schematic diff_comp_out_buffer.kicad_sch, Trigger Output FMC]

Parts:
C1, C2: 100nF; C_0603_1608Metric; MPN GCM188R71H104KA57J
C99: 10nF; C_0603_1608Metric; MPN GRM1885C1H103JA01D
C120: 1uF; C_0603_1608Metric; MPN GCM188R71E105KA64D
R1: 100R; R_0402_1005Metric; MPN RC0402FR-07100RL
R2, R3: 88.7R; R_0805_2012Metric; MPN CRCW080588R7FKEA
U1: TLV3601; SOT-23-5; MPN TLV3601DBVR
U48: SN74LVC2G126; VSSOP-8_2.3x2mm_P0.5mm; MPN SN74LVC2G126DCUT

Connections:
/Digital IO/D_Output0.N: R1.2, U1.4 (-); also elsewhere on the board
/Digital IO/D_Output0.P: R1.1, U1.3 (+); also elsewhere on the board
/Digital IO/OE_A: U48.1 (1OE), U48.7 (2OE); also elsewhere on the board
/Digital IO/VCC: C1.2, C2.2, C99.2, C120.2, U1.5 (V+), U48.8 (V_{CC}); also elsewhere on the board
/Digital IO/out_buffer0/Out: R2.2, R3.2; also elsewhere on the board
GND: C1.1, C2.1, C99.1, C120.1, U1.2 (V-), U48.4 (GND); also elsewhere on the board
unnamed: U1.1, U48.2 (1A), U48.5 (2A)
unnamed: R2.1, U48.6 (1Y)
unnamed: R3.1, U48.3 (2Y)

Parts of its further copies:
C3, C4, C5, C6, C7, C8, C9, C10, C11, C12, C13, C14, C15, C16, C80, C81, C82, C83, C84, C85, C86, C87, C88, C89, C90, C91, C92, C93, C94, C100: 100nF; C_0603_1608Metric; MPN GCM188R71H104KA57J
C105, C106, C107, C108, C109, C110, C111, C112, C113, C114, C115, C116, C117, C118, C119: 10nF; C_0603_1608Metric; MPN GRM1885C1H103JA01D
C121, C122, C123, C124, C125, C126, C127, C128, C129, C130, C131, C132, C133, C134, C135: 1uF; C_0603_1608Metric; MPN GCM188R71E105KA64D
R4, R7, R21, R24, R27, R30, R33, R36, R39, R45, R48, R51, R54, R57, R69: 100R; R_0402_1005Metric; MPN RC0402FR-07100RL
R5, R6, R8, R9, R22, R23, R25, R26, R28, R29, R31, R32, R34, R35, R37, R38, R40, R41, R46, R47, R49, R50, R52, R53, R55, R56, R58, R59, R71, R72: 88.7R; R_0805_2012Metric; MPN CRCW080588R7FKEA
U2, U3, U6, U8, U11, U13, U15, U17, U30, U32, U34, U36, U38, U40, U42: TLV3601; SOT-23-5; MPN TLV3601DBVR
U4, U5, U7, U10, U12, U14, U16, U29, U31, U33, U35, U37, U39, U41, U43: SN74LVC2G126; VSSOP-8_2.3x2mm_P0.5mm; MPN SN74LVC2G126DCUT

Connections of its further copies:
/Digital IO/D_Output1.N: R4.2, U3.4 (-); also elsewhere on the board
/Digital IO/D_Output1.P: R4.1, U3.3 (+); also elsewhere on the board
/Digital IO/D_Output2.N: R7.2, U2.4 (-); also elsewhere on the board
/Digital IO/D_Output2.P: R7.1, U2.3 (+); also elsewhere on the board
/Digital IO/D_Output3.N: R21.2, U6.4 (-); also elsewhere on the board
/Digital IO/D_Output3.P: R21.1, U6.3 (+); also elsewhere on the board
/Digital IO/D_Output4.N: R24.2, U8.4 (-); also elsewhere on the board
/Digital IO/D_Output4.P: R24.1, U8.3 (+); also elsewhere on the board
/Digital IO/D_Output5.N: R27.2, U11.4 (-); also elsewhere on the board
/Digital IO/D_Output5.P: R27.1, U11.3 (+); also elsewhere on the board
/Digital IO/D_Output6.N: R30.2, U13.4 (-); also elsewhere on the board
/Digital IO/D_Output6.P: R30.1, U13.3 (+); also elsewhere on the board
/Digital IO/D_Output7.N: R33.2, U15.4 (-); also elsewhere on the board
/Digital IO/D_Output7.P: R33.1, U15.3 (+); also elsewhere on the board
/Digital IO/D_Output8.N: R36.2, U17.4 (-); also elsewhere on the board
/Digital IO/D_Output8.P: R36.1, U17.3 (+); also elsewhere on the board
/Digital IO/D_Output9.N: R39.2, U30.4 (-); also elsewhere on the board
/Digital IO/D_Output9.P: R39.1, U30.3 (+); also elsewhere on the board
/Digital IO/D_Output10.N: R45.2, U32.4 (-); also elsewhere on the board
/Digital IO/D_Output10.P: R45.1, U32.3 (+); also elsewhere on the board
/Digital IO/D_Output11.N: R48.2, U34.4 (-); also elsewhere on the board
/Digital IO/D_Output11.P: R48.1, U34.3 (+); also elsewhere on the board
/Digital IO/D_Output12.N: R51.2, U36.4 (-); also elsewhere on the board
/Digital IO/D_Output12.P: R51.1, U36.3 (+); also elsewhere on the board
/Digital IO/D_Output13.N: R54.2, U38.4 (-); also elsewhere on the board
/Digital IO/D_Output13.P: R54.1, U38.3 (+); also elsewhere on the board
/Digital IO/D_Output14.N: R57.2, U40.4 (-); also elsewhere on the board
/Digital IO/D_Output14.P: R57.1, U40.3 (+); also elsewhere on the board
/Digital IO/D_Output15.N: R69.2, U42.4 (-); also elsewhere on the board
/Digital IO/D_Output15.P: R69.1, U42.3 (+); also elsewhere on the board
/Digital IO/OE_A: U4.1 (1OE), U4.7 (2OE), U5.1 (1OE), U5.7 (2OE), U7.1 (1OE), U7.7 (2OE), U10.1 (1OE), U10.7 (2OE), U12.1 (1OE), U12.7 (2OE), U14.1 (1OE), U14.7 (2OE), U16.1 (1OE), U16.7 (2OE); also elsewhere on the board
/Digital IO/OE_B: U29.1 (1OE), U29.7 (2OE), U31.1 (1OE), U31.7 (2OE), U33.1 (1OE), U33.7 (2OE), U35.1 (1OE), U35.7 (2OE), U37.1 (1OE), U37.7 (2OE), U39.1 (1OE), U39.7 (2OE), U41.1 (1OE), U41.7 (2OE), U43.1 (1OE), U43.7 (2OE); also elsewhere on the board
/Digital IO/VCC: C3.2, C4.2, C5.2, C6.2, C7.2, C8.2, C9.2, C10.2, C11.2, C12.2, C13.2, C14.2, C15.2, C16.2, C80.2, C81.2, C82.2, C83.2, C84.2, C85.2, C86.2, C87.2, C88.2, C89.2, C90.2, C91.2, C92.2, C93.2, C94.2, C100.2, C105.2, C106.2, C107.2, C108.2, C109.2, C110.2, C111.2, C112.2, C113.2, C114.2, C115.2, C116.2, C117.2, C118.2, C119.2, C121.2, C122.2, C123.2, C124.2, C125.2, C126.2, C127.2, C128.2, C129.2, C130.2, C131.2, C132.2, C133.2, C134.2, C135.2, U2.5 (V+), U3.5 (V+), U4.8 (V_{CC}), U5.8 (V_{CC}), U6.5 (V+), U7.8 (V_{CC}), U8.5 (V+), U10.8 (V_{CC}), U11.5 (V+), U12.8 (V_{CC}), U13.5 (V+), U14.8 (V_{CC}), U15.5 (V+), U16.8 (V_{CC}), U17.5 (V+), U29.8 (V_{CC}), U30.5 (V+), U31.8 (V_{CC}), U32.5 (V+), U33.8 (V_{CC}), U34.5 (V+), U35.8 (V_{CC}), U36.5 (V+), U37.8 (V_{CC}), U38.5 (V+), U39.8 (V_{CC}), U40.5 (V+), U41.8 (V_{CC}), U42.5 (V+), U43.8 (V_{CC}); also elsewhere on the board
/Digital IO/out_buffer1/Out: R5.2, R6.2; also elsewhere on the board
/Digital IO/out_buffer2/Out: R8.2, R9.2; also elsewhere on the board
/Digital IO/out_buffer3/Out: R22.2, R23.2; also elsewhere on the board
/Digital IO/out_buffer4/Out: R25.2, R26.2; also elsewhere on the board
/Digital IO/out_buffer5/Out: R28.2, R29.2; also elsewhere on the board
/Digital IO/out_buffer6/Out: R31.2, R32.2; also elsewhere on the board
/Digital IO/out_buffer7/Out: R34.2, R35.2; also elsewhere on the board
/Digital IO/out_buffer8/Out: R37.2, R38.2; also elsewhere on the board
/Digital IO/out_buffer9/Out: R40.2, R41.2; also elsewhere on the board
/Digital IO/out_buffer10/Out: R46.2, R47.2; also elsewhere on the board
/Digital IO/out_buffer11/Out: R49.2, R50.2; also elsewhere on the board
/Digital IO/out_buffer12/Out: R52.2, R53.2; also elsewhere on the board
/Digital IO/out_buffer13/Out: R55.2, R56.2; also elsewhere on the board
/Digital IO/out_buffer14/Out: R58.2, R59.2; also elsewhere on the board
/Digital IO/out_buffer15/Out: R71.2, R72.2; also elsewhere on the board
GND: C3.1, C4.1, C5.1, C6.1, C7.1, C8.1, C9.1, C10.1, C11.1, C12.1, C13.1, C14.1, C15.1, C16.1, C80.1, C81.1, C82.1, C83.1, C84.1, C85.1, C86.1, C87.1, C88.1, C89.1, C90.1, C91.1, C92.1, C93.1, C94.1, C100.1, C105.1, C106.1, C107.1, C108.1, C109.1, C110.1, C111.1, C112.1, C113.1, C114.1, C115.1, C116.1, C117.1, C118.1, C119.1, C121.1, C122.1, C123.1, C124.1, C125.1, C126.1, C127.1, C128.1, C129.1, C130.1, C131.1, C132.1, C133.1, C134.1, C135.1, U2.2 (V-), U3.2 (V-), U4.4 (GND), U5.4 (GND), U6.2 (V-), U7.4 (GND), U8.2 (V-), U10.4 (GND), U11.2 (V-), U12.4 (GND), U13.2 (V-), U14.4 (GND), U15.2 (V-), U16.4 (GND), U17.2 (V-), U29.4 (GND), U30.2 (V-), U31.4 (GND), U32.2 (V-), U33.4 (GND), U34.2 (V-), U35.4 (GND), U36.2 (V-), U37.4 (GND), U38.2 (V-), U39.4 (GND), U40.2 (V-), U41.4 (GND), U42.2 (V-), U43.4 (GND); also elsewhere on the board
unnamed: U3.1, U4.2 (1A), U4.5 (2A)
unnamed: R5.1, U4.6 (1Y)
unnamed: R6.1, U4.3 (2Y)
unnamed: U2.1, U5.2 (1A), U5.5 (2A)
unnamed: R8.1, U5.6 (1Y)
unnamed: R9.1, U5.3 (2Y)
unnamed: U6.1, U7.2 (1A), U7.5 (2A)
unnamed: R22.1, U7.6 (1Y)
unnamed: R23.1, U7.3 (2Y)
unnamed: U8.1, U10.2 (1A), U10.5 (2A)
unnamed: R25.1, U10.6 (1Y)
unnamed: R26.1, U10.3 (2Y)
unnamed: U11.1, U12.2 (1A), U12.5 (2A)
unnamed: R28.1, U12.6 (1Y)
unnamed: R29.1, U12.3 (2Y)
unnamed: U13.1, U14.2 (1A), U14.5 (2A)
unnamed: R31.1, U14.6 (1Y)
unnamed: R32.1, U14.3 (2Y)
unnamed: U15.1, U16.2 (1A), U16.5 (2A)
unnamed: R34.1, U16.6 (1Y)
unnamed: R35.1, U16.3 (2Y)
unnamed: U17.1, U29.2 (1A), U29.5 (2A)
unnamed: R37.1, U29.6 (1Y)
unnamed: R38.1, U29.3 (2Y)
unnamed: U30.1, U31.2 (1A), U31.5 (2A)
unnamed: R40.1, U31.6 (1Y)
unnamed: R41.1, U31.3 (2Y)
unnamed: U32.1, U33.2 (1A), U33.5 (2A)
unnamed: R46.1, U33.6 (1Y)
unnamed: R47.1, U33.3 (2Y)
unnamed: U34.1, U35.2 (1A), U35.5 (2A)
unnamed: R49.1, U35.6 (1Y)
unnamed: R50.1, U35.3 (2Y)
unnamed: U36.1, U37.2 (1A), U37.5 (2A)
unnamed: R52.1, U37.6 (1Y)
unnamed: R53.1, U37.3 (2Y)
unnamed: U38.1, U39.2 (1A), U39.5 (2A)
unnamed: R55.1, U39.6 (1Y)
unnamed: R56.1, U39.3 (2Y)
unnamed: U40.1, U41.2 (1A), U41.5 (2A)
unnamed: R58.1, U41.6 (1Y)
unnamed: R59.1, U41.3 (2Y)
unnamed: U42.1, U43.2 (1A), U43.5 (2A)
unnamed: R71.1, U43.6 (1Y)
unnamed: R72.1, U43.3 (2Y)

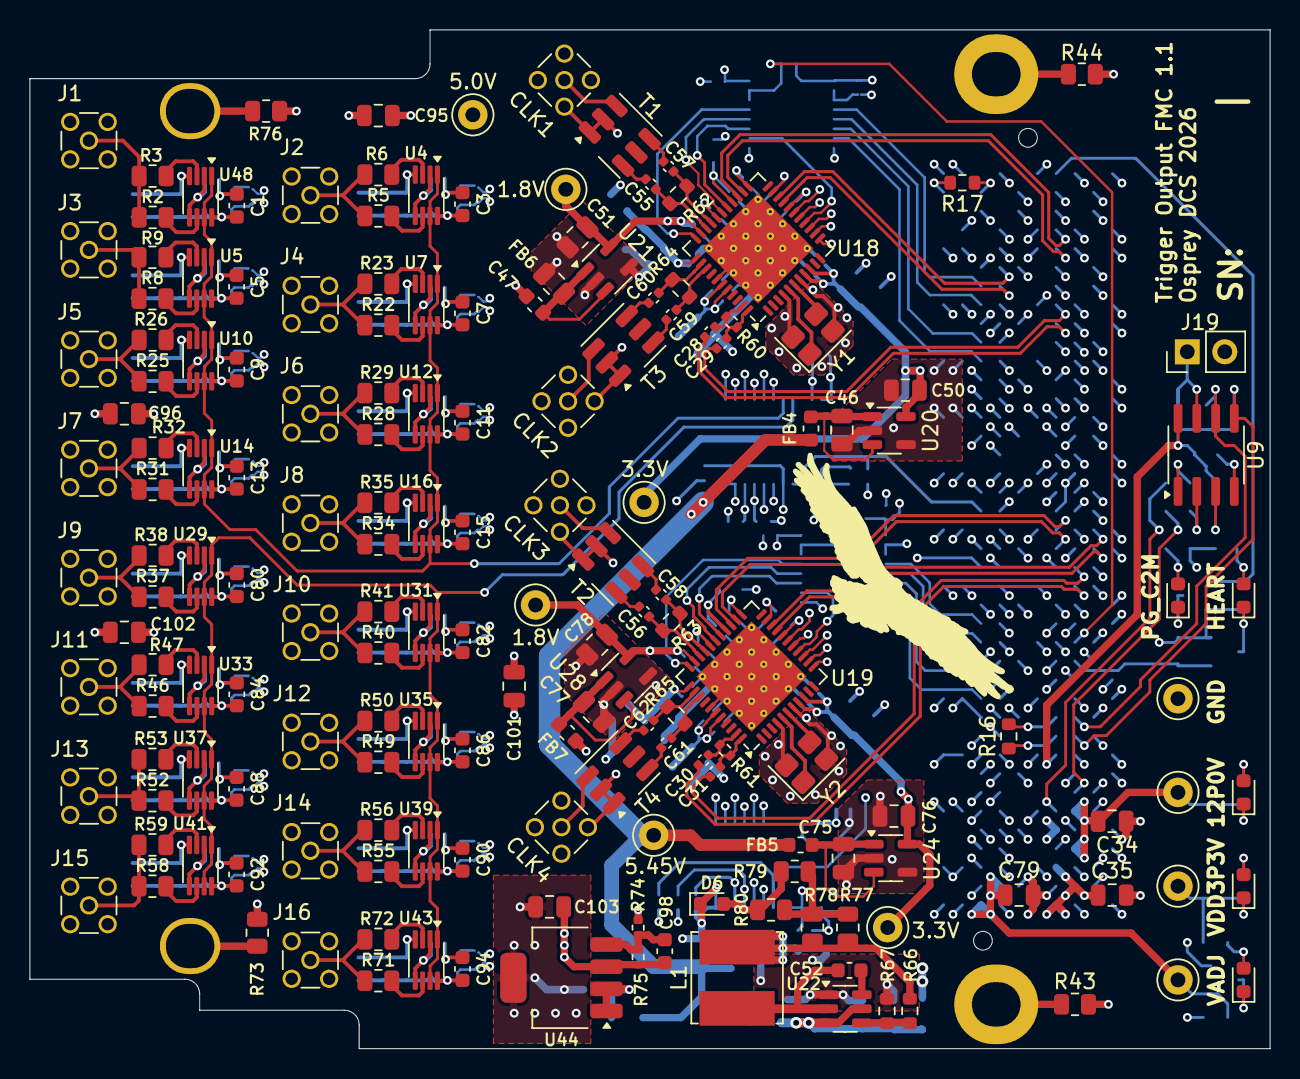
[picture p9: board trigger-output-fmc.kicad_pcb from above]

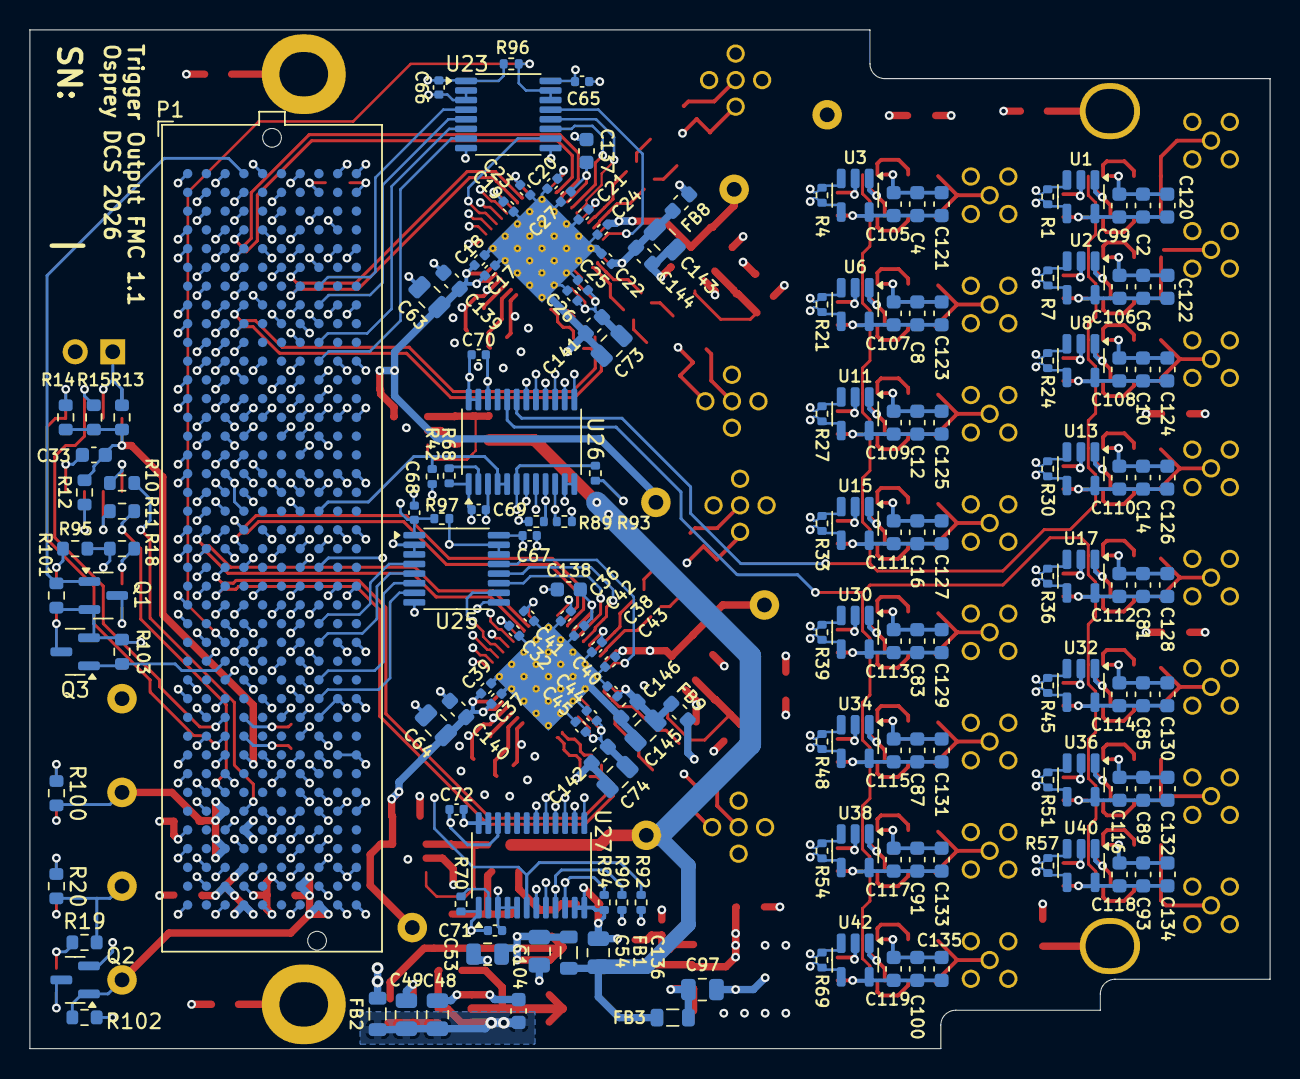
[picture p10: board trigger-output-fmc.kicad_pcb from below]

Board: 8 copper layers, 84.0 x 69.0 mm, 346 parts (170 on the bottom side), 232 nets.
