osprey-dcs/trigger-output-fmc/(notices)

Notices in the files:
digital_inputs.kicad_sch:
SPDX-FileCopyrightText: 2025 Osprey DCS
SPDX-License-Identifier: CERN-OHL-S-2.0+
